jlunder/amanita-arcade/hardware/analysis.ods

Options -
 | Iterm | Ircvr | Ileds
a) Active termination (2.5V) | 0.05 | 0.023 | 0.02 | 0.093
b) Passive termination (2.5V) | 0.005 | 0.023 | 0.02 | 0.048
