jlunder/amanita-arcade/data-source/fonts/nixie_numbers.jpg

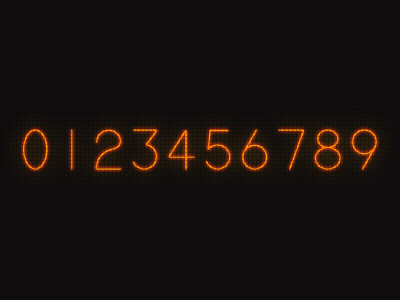
data-source/fonts/nixie_numbers.jpg
