jlunder/amanita-arcade/hardware/assembly-2019-06-28/aa-bom-v1.ods

AA-POWER
Designator | Package | Qty | Designation
C2, C1 | CP_Radial_D5.0mm_P2.50mm | 2 | 10u
C4, C3 | C_0805_2012Metric | 2 | 1u
CN1 | SolderWirePad_1x02_P5.08mm_Drill1.5mm | 1 | VIN_A
CN2 | SolderWirePad_1x02_P5.08mm_Drill1.5mm | 1 | VIN_B
CN3 | TerminalBlock_OST_OSTYK44108030 | 1 | 12V_OUT
CN4 | TerminalBlock_OST_OSTYK44108030 | 1 | GND_OUT
D2, D1 | D_SOD-923 | 2 | DF2S16FS
D3, D4, D7 | LED_0603_1608Metric | 3 | LED
D5, D6 | D_SOD-128 | 2 | TSS83L45
D8 | D_DO-35_SOD27_P2.54mm_Vertical_KathodeUp | 1 | BZX79C15
F1 | Fuseholder_Clip_5x20_Bel_FC-211-22 | 1 | 2A
Q1 | TO-220-3_Horizontal_TabDown | 1 | TN1610H
R2, R1, R3 | R_0603_1608Metric | 3 | 2.2k
R4 | R_0603_1608Metric | 1 | 470
R5 | R_0603_1608Metric | 1 | 10k
TP1, TP11, TP3, TP5, TP7, TP9 | TestPoint_Loop_D1.80mm_Drill1.0mm_Beaded | 6
TP12, TP10, TP8, TP6, TP4, TP2 | TestPoint_Loop_D1.80mm_Drill1.0mm_Beaded | 6 | GND
AA-DAUGHTERBOARD
Designator | Package | Qty | Designation
A1 | STM32F407_Discovery_P1_P2_Socket | 1
C1 | CP_Radial_D10.0mm_P2.50mm_P5.00mm | 1 | 100u
C13, C3, C6, C14, C7, C12 | C_0603_1608Metric | 6 | 0.1u
C17, C16, C9, C8, C2, C15 | C_0805_2012Metric | 6 | 1u
C4, C5 | C_0805_2012Metric | 2 | 10u
CN1 | BarrelJack_Horizontal | 1 | Barrel_Jack
CN12, CN11, CN13, CN5, CN10 | 6P6C_Assmann_A-2014-1-4 | 5 | 6P6C
CN15, CN16, CN14 | PinHeader_2x04_P2.54mm_Vertical | 3
CN19, CN18, CN17 | 8P8C_Assmann_A-2014-2S-4 | 3 | 8P8C
CN2 | SolderWirePad_1x02_P5.08mm_Drill1.5mm | 1
CN4, CN3 | PinHeader_1x06_P2.54mm_Vertical | 2
CN6, CN7, CN8, CN9 | PinHeader_1x04_P2.54mm_Vertical | 4
D14, D10, D11, D12, D13, D15, D16, D17, D18, D19 | SOT-23-6 | 10 | DT1042
D20, D21, D1, D9, D5, D4, D7, D8 | LED_0603_1608Metric | 8 | LED
D3 | D_SOD-923 | 1 | DF2S16FS
D6 | SOT-23-6 | 1 | D5V0P4UR6SO
F1 | Fuseholder_Clip_5x20_Bel_FC-211-22 | 1 | 0.5A
F5, F4, F3, F2 | Fuse_0805_2012Metric | 4 | 0.5A
R15 | R_0603_1608Metric | 1 | 33
R3, R4 | R_0603_1608Metric | 2 | 120
R33, R50, R30, R31, R28, R34, R43, R47, R21, R41, R39, R38, R37, R36, R55, R48, R32, R16, R46, R42, R54, R53, R52, R35, R51, R24, R23, R25, R44, R19, R26, R49, R45, R18, R22, R40, R20, R29, R17, R27 | R_0603_1608Metric | 40 | 56
R56, R10, R12 | R_0603_1608Metric | 3 | 10k
R57 | R_0603_1608Metric | 1 | 2.2k
R58 | R_0603_1608Metric | 1 | 680
R7, R6 | R_0603_1608Metric | 2 | 1k
R9, R8, R11, R13, R14, R2 | R_0603_1608Metric | 6 | 220
TP32, TP13, TP6, TP1, TP2, TP3, TP4, TP14, TP31, TP12, TP5, TP7, TP8, TP11, TP10, TP9, TP16, TP24, TP17, TP18, TP19, TP20, TP21, TP23, TP25, TP26, TP27, TP28, TP29, TP15, TP22, TP30 | TestPoint_THTPad_D2.0mm_Drill1.0mm | 32
U1 | DIP-8_W7.62mm_Socket | 1 | 24LC08
U2 | DFN-10-1EP_3x3mm_P0.5mm_EP1.75x2.7mm | 1 | NIS5132xx
U3 | TO-220-3_Horizontal_TabDown | 1 | uA7805
U3_ALT | PinHeader_1x03_P2.54mm_Vertical | 1
U7, U6, U5, U4, U8 | SOIC-16_3.9x9.9mm_P1.27mm | 5 | 75ALS192
AA-STALK-RECEIVER
Designator | Package | Qty | Designation
C101 | CP_Radial_D10.0mm_P2.50mm_P5.00mm | 1 | 100u
C102 | CP_Radial_D5.0mm_P2.50mm | 1 | 10u
C103, C204 | C_0805_2012Metric | 2 | 1u
C202, C203, C301 | C_0805_2012Metric | 3 | 0.1u
C311, C312 | C_0805_2012Metric | 2 | 10u
CN101 | SolderWirePad_1x02_P7.62mm_Drill2.5mm | 1
CN102 | 6P6C_Assmann_A-2014-1-4 | 1 | 6P6C
CN151 | PinHeader_1x04_P2.54mm_Vertical | 1
CN301, CN302, CN303 | PinHeader_1x03_P2.54mm_Vertical | 3
CN314, CN313, CN312, CN311 | PinHeader_1x02_P2.54mm_Vertical | 4
D101 | D_SOD-923 | 1 | DF2S16FS
D102 | SOT-23-6 | 1 | D5V0P4UR6SO
D151, D152, D352, D351 | D_0603_1608Metric | 4 | LED
D204, D202, D201, D203 | D_DO-35_SOD27_P7.62mm_Horizontal | 4 | BZX79C2V7
JP101 | PinHeader_1x02_P2.54mm_Vertical | 1
Q301 | SOT-23 | 1 | KST10
Q311, Q312 | SOT-323_SC-70 | 2 | MCH3484
R151 | R_0603_1608Metric | 1 | 1.5k
R201, R204, R202, R203 | R_0603_1608Metric | 4 | 56
R301, R302 | R_0603_1608Metric | 2 | 1k
R351, R352, R152 | R_0603_1608Metric | 3 | 470
TP101, TP102, TP201, TP202, TP301, TP302, TP303, TP311 | TestPoint_Loop_D1.80mm_Drill1.0mm_Beaded | 8
TP151, TP152, TP153, TP251, TP351, TP352, TP361, TP252 | TestPoint_Loop_D1.80mm_Drill1.0mm_Beaded | 8 | GND
U201 | SOIC-16_3.9x9.9mm_P1.27mm | 1 | ST26C32
AA-PANEL-RECEIVER
Designator | Package | Qty | Designation
C101 | CP_Radial_D10.0mm_P2.50mm_P5.00mm | 1 | 100u
C102 | CP_Radial_D6.3mm_P2.50mm | 1 | 10u
C201, C301 | C_0603_1608Metric | 2 | 1u
C321, C311, C202, C304, C203, C204, C211, C221, C302, C303 | C_0603_1608Metric | 10 | 0.1u
CN102, CN101 | SolderWirePad_1x02_P5.08mm_Drill1.5mm | 2 | Conn_01x02
CN301, CN201 | 8P8C_Assmann_A-2014-2S-4 | 2 | 8P8C
CN351, CN302, CN251, CN202 | PinHeader_2x04_P2.54mm_Vertical | 4 | Conn_01x08
D102, D101 | D_SOD-128 | 2 | TSS83L45
D151, D152 | LED_0603_1608Metric | 2 | LED
D222, D322, D321, D312, D311, D221, D212, D211 | D_DO-35_SOD27_P2.54mm_Vertical_KathodeUp | 8 | D_Zener
D301, D302, D202, D201 | SOT-23-6 | 4 | D5V0P4UR6SO
R151, R152 | R_0603_1608Metric | 2 | 470
R304, R307, R303, R308, R301, R302, R306, R305, R208, R205, R206, R207, R201, R202, R203, R204 | R_0603_1608Metric | 16 | 56
TP101, TP102, TP103, TP104, TP201, TP202, TP203, TP204, TP211, TP221, TP201, TP302, TP303, TP304, TP311, TP321 | TestPoint_Loop_D1.80mm_Drill1.0mm_Beaded | 16
TP151, TP153, TP254, TP251, TP252, TP253, TP152, TP271, TP371, TP361, TP354, TP353, TP351, TP352, TP261 | TestPoint_Loop_D1.80mm_Drill1.0mm_Beaded | 15 | GND
U101 | Converter_DCDC_muRata_CRE1xxxxxx3C_THT | 1 | CRE1S0505S3C
U301, U201 | SOIC-16_3.9x9.9mm_P1.27mm | 2 | ST26C32
U302, U202 | QSOP-16_3.9x4.9mm_P0.635mm | 2 | Si8640EB-B-IU
AA-INPUT-CONTROLLER
Designator | Package | Qty | Designation
A201 | STM32F103_Bluepill | 1
C101 | CP_Radial_D10.0mm_P2.50mm_P5.00mm | 1 | 10u
C211,C221,C231,C241 | C_0805_2012Metric | 4 | 1u
CN101 | SolderWirePad_1x02_P5.08mm_Drill1.5mm | 1
CN201 | 6P6C_Assmann_A-2014-1-4 | 1 | INPUT
CN202 | Connector_SonyPS2DualShock_Female | 1
CN203,CN251 | PinHeader_1x06_P2.54mm_Vertical | 2
CN211 | 6P6C_Assmann_A-2014-1-4 | 1 | BTN_R
CN221 | 6P6C_Assmann_A-2014-1-4 | 1 | BTN_G
CN231 | 6P6C_Assmann_A-2014-1-4 | 1 | BTN_B
CN241 | 6P6C_Assmann_A-2014-1-4 | 1 | BTN_P
Q231,Q221,Q211,Q241 | SOT-323_SC-70 | 4 | MCH3484
R208,R201 | R_0603_1608Metric | 2 | 1k
R209,R202 | R_0603_1608Metric | 2 | 120
R241, R231, R221, R207, R206, R205, R204, R203, R211 | R_0603_1608Metric | 9 | 4.7k
TP101, TP102, TP211, TP212, TP213, TP221, TP222, TP223, TP231, TP232, TP233, TP241, TP242, TP243 | TestPoint_Loop_D1.80mm_Drill1.0mm_Beaded | 14
TP151, TP152, TP251, TP252, TP253, TP254, TP261, TP271, TP281, TP291 | TestPoint_Loop_D1.80mm_Drill1.0mm_Beaded | 10 | GND
U101 | TO-220-3_Horizontal_TabDown | 1 | LM7805_TO220
