jlunder/amanita-arcade/hardware/assembly-2019-06-28/aa-daughterboard.pdf

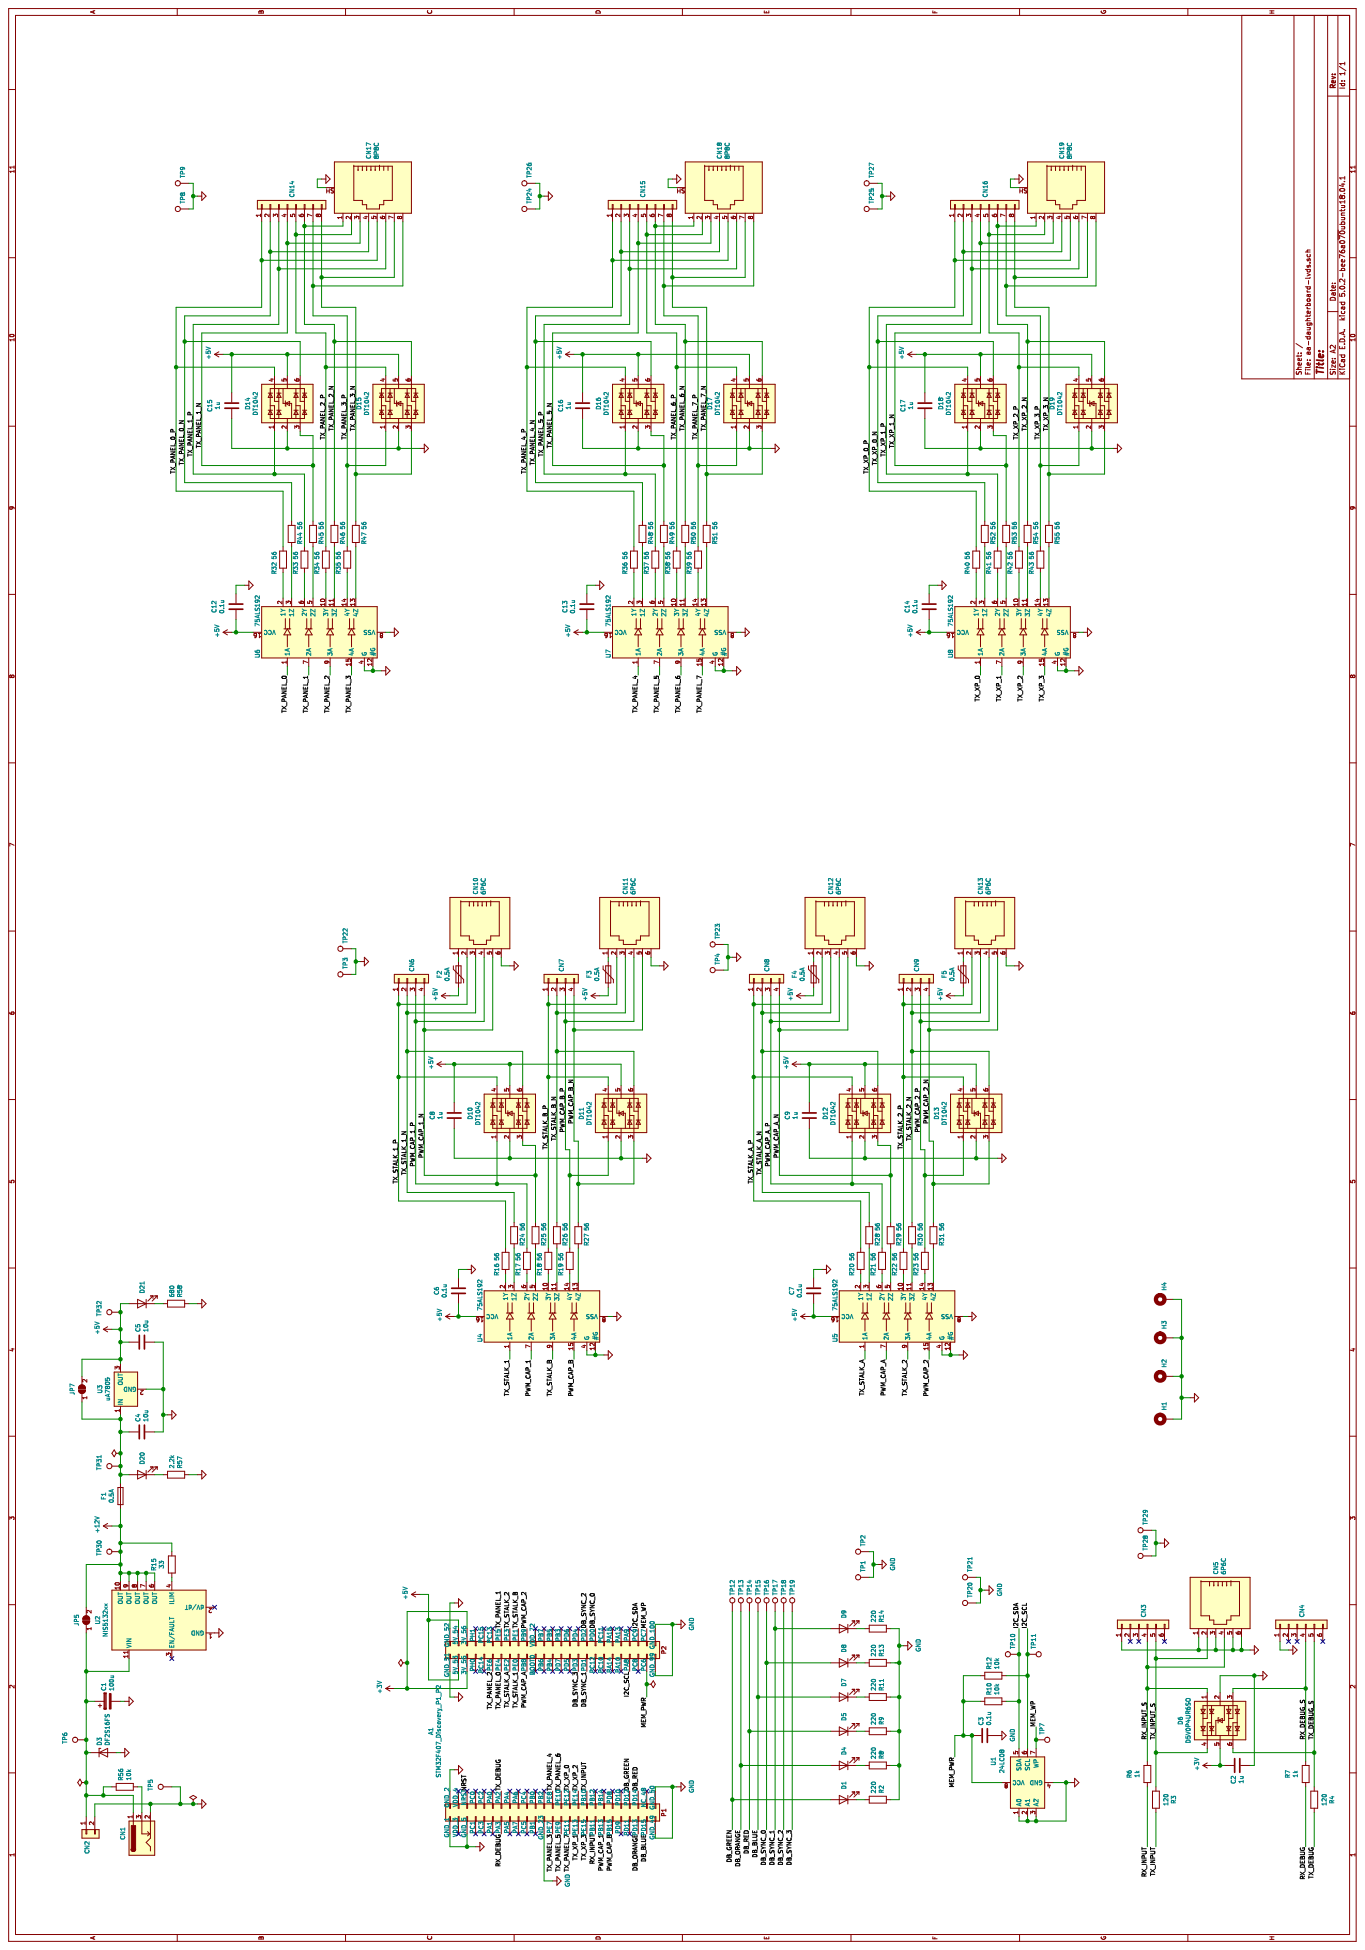
[picture p2: page 1]
