jlunder/amanita-arcade/hardware/assembly-2019-06-28/aa-input-controller.pdf

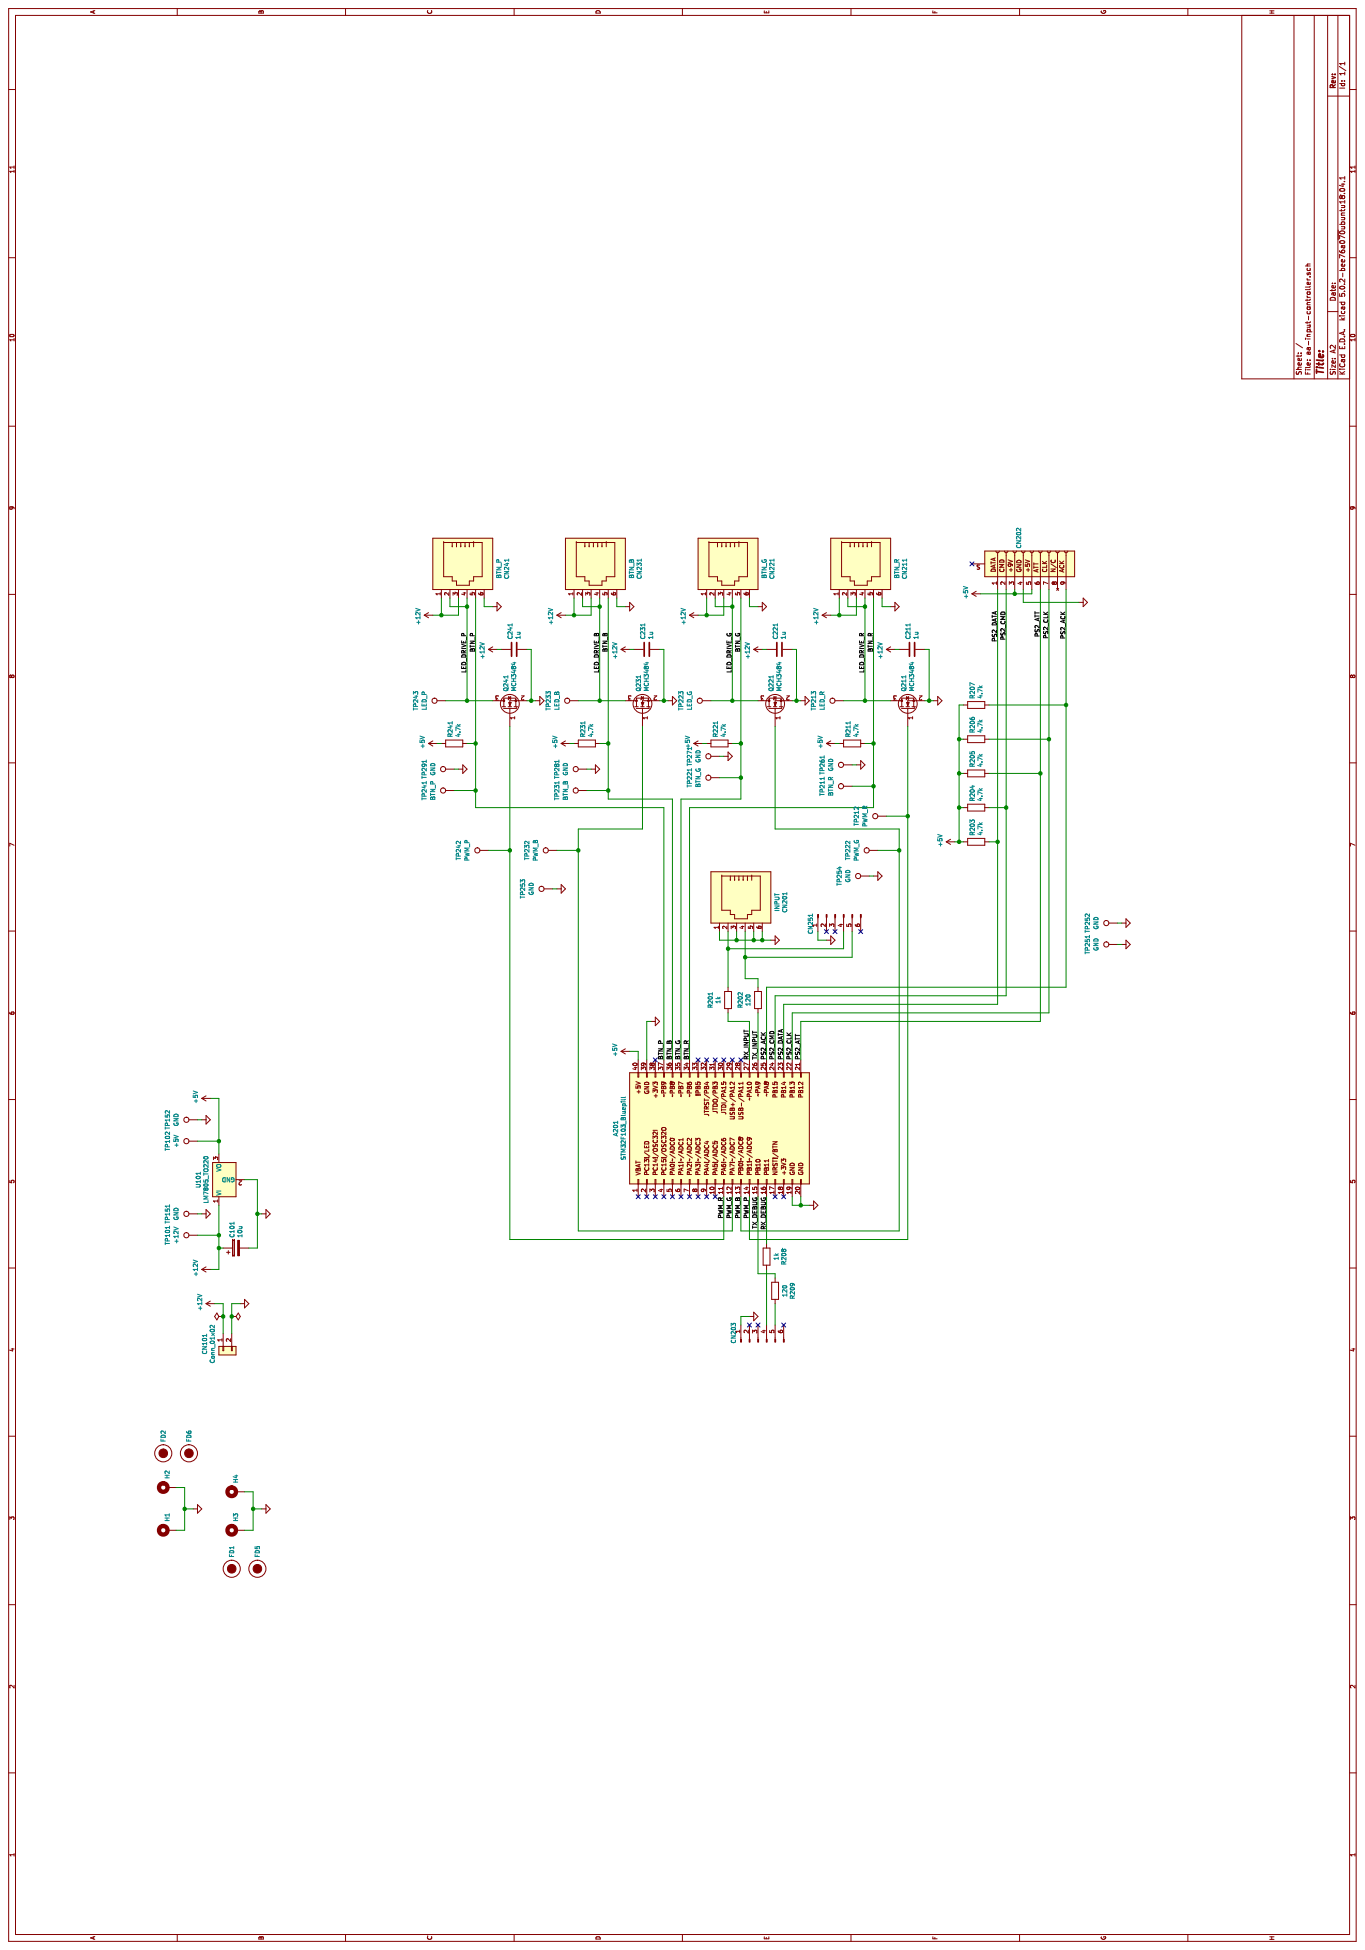
[picture p3: page 1]
