jlunder/amanita-arcade/hardware/assembly-2019-06-28/aa-panel-receiver.pdf

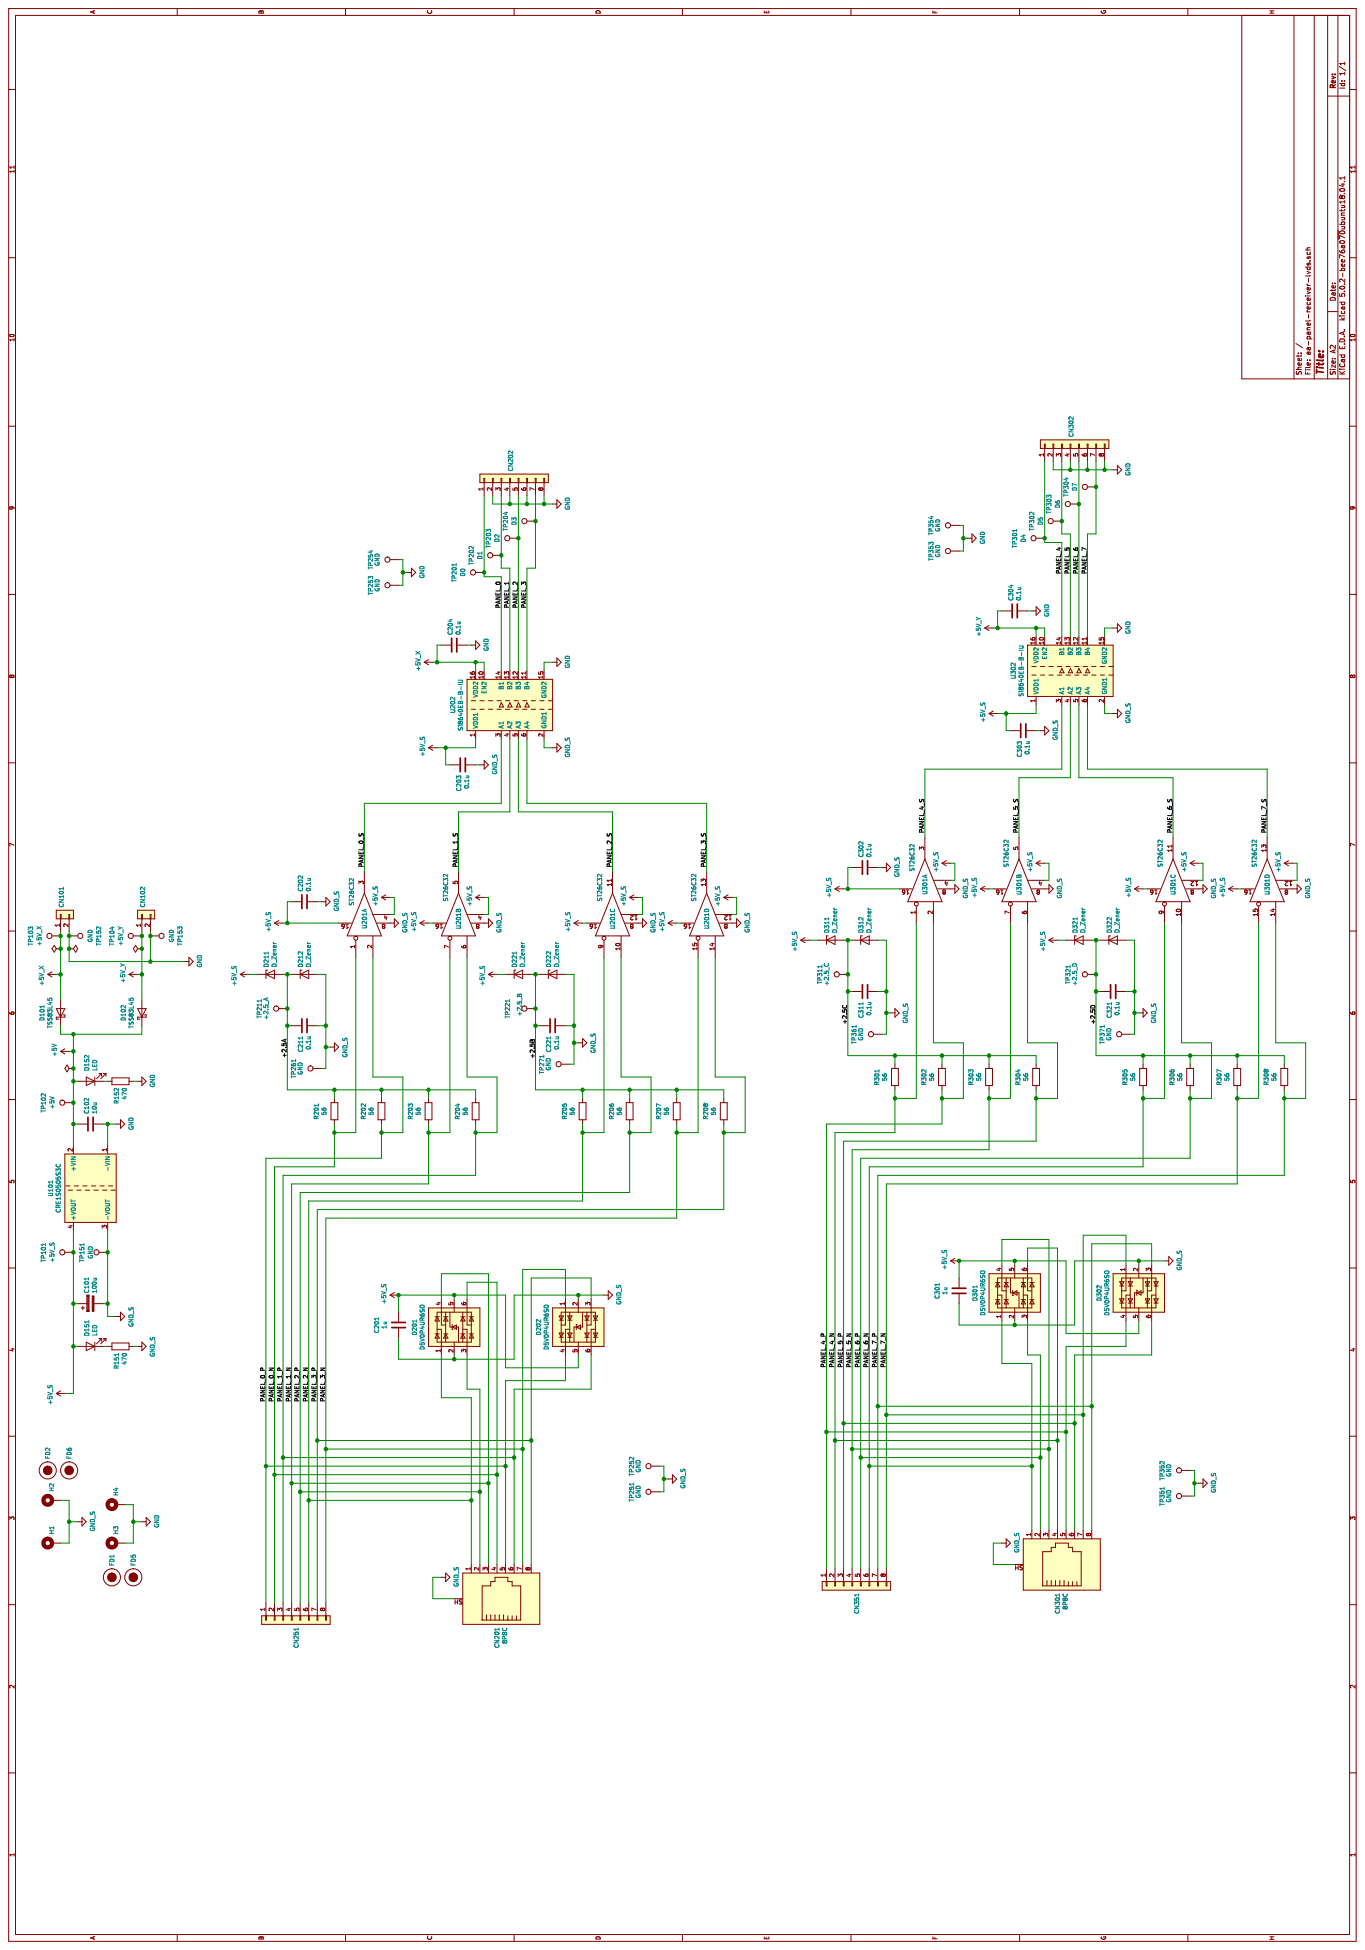
[picture p4: page 1]
