jlunder/amanita-arcade/hardware/assembly-2019-06-28/aa-power.pdf

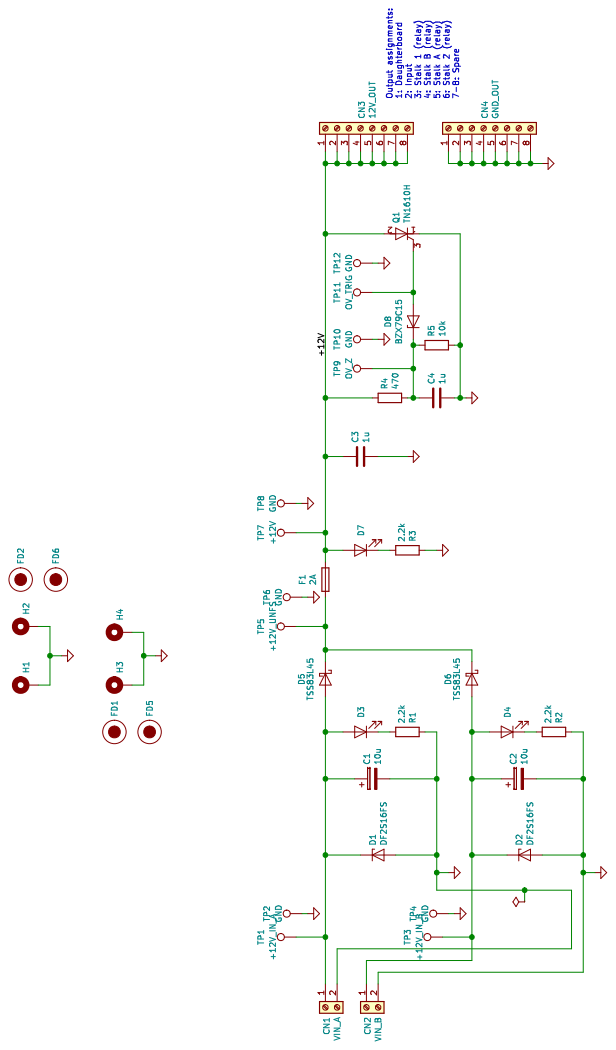
[picture p5: page 1]
