jlunder/amanita-arcade/hardware/assembly-2019-06-28/aa-stalk-receiver.pdf

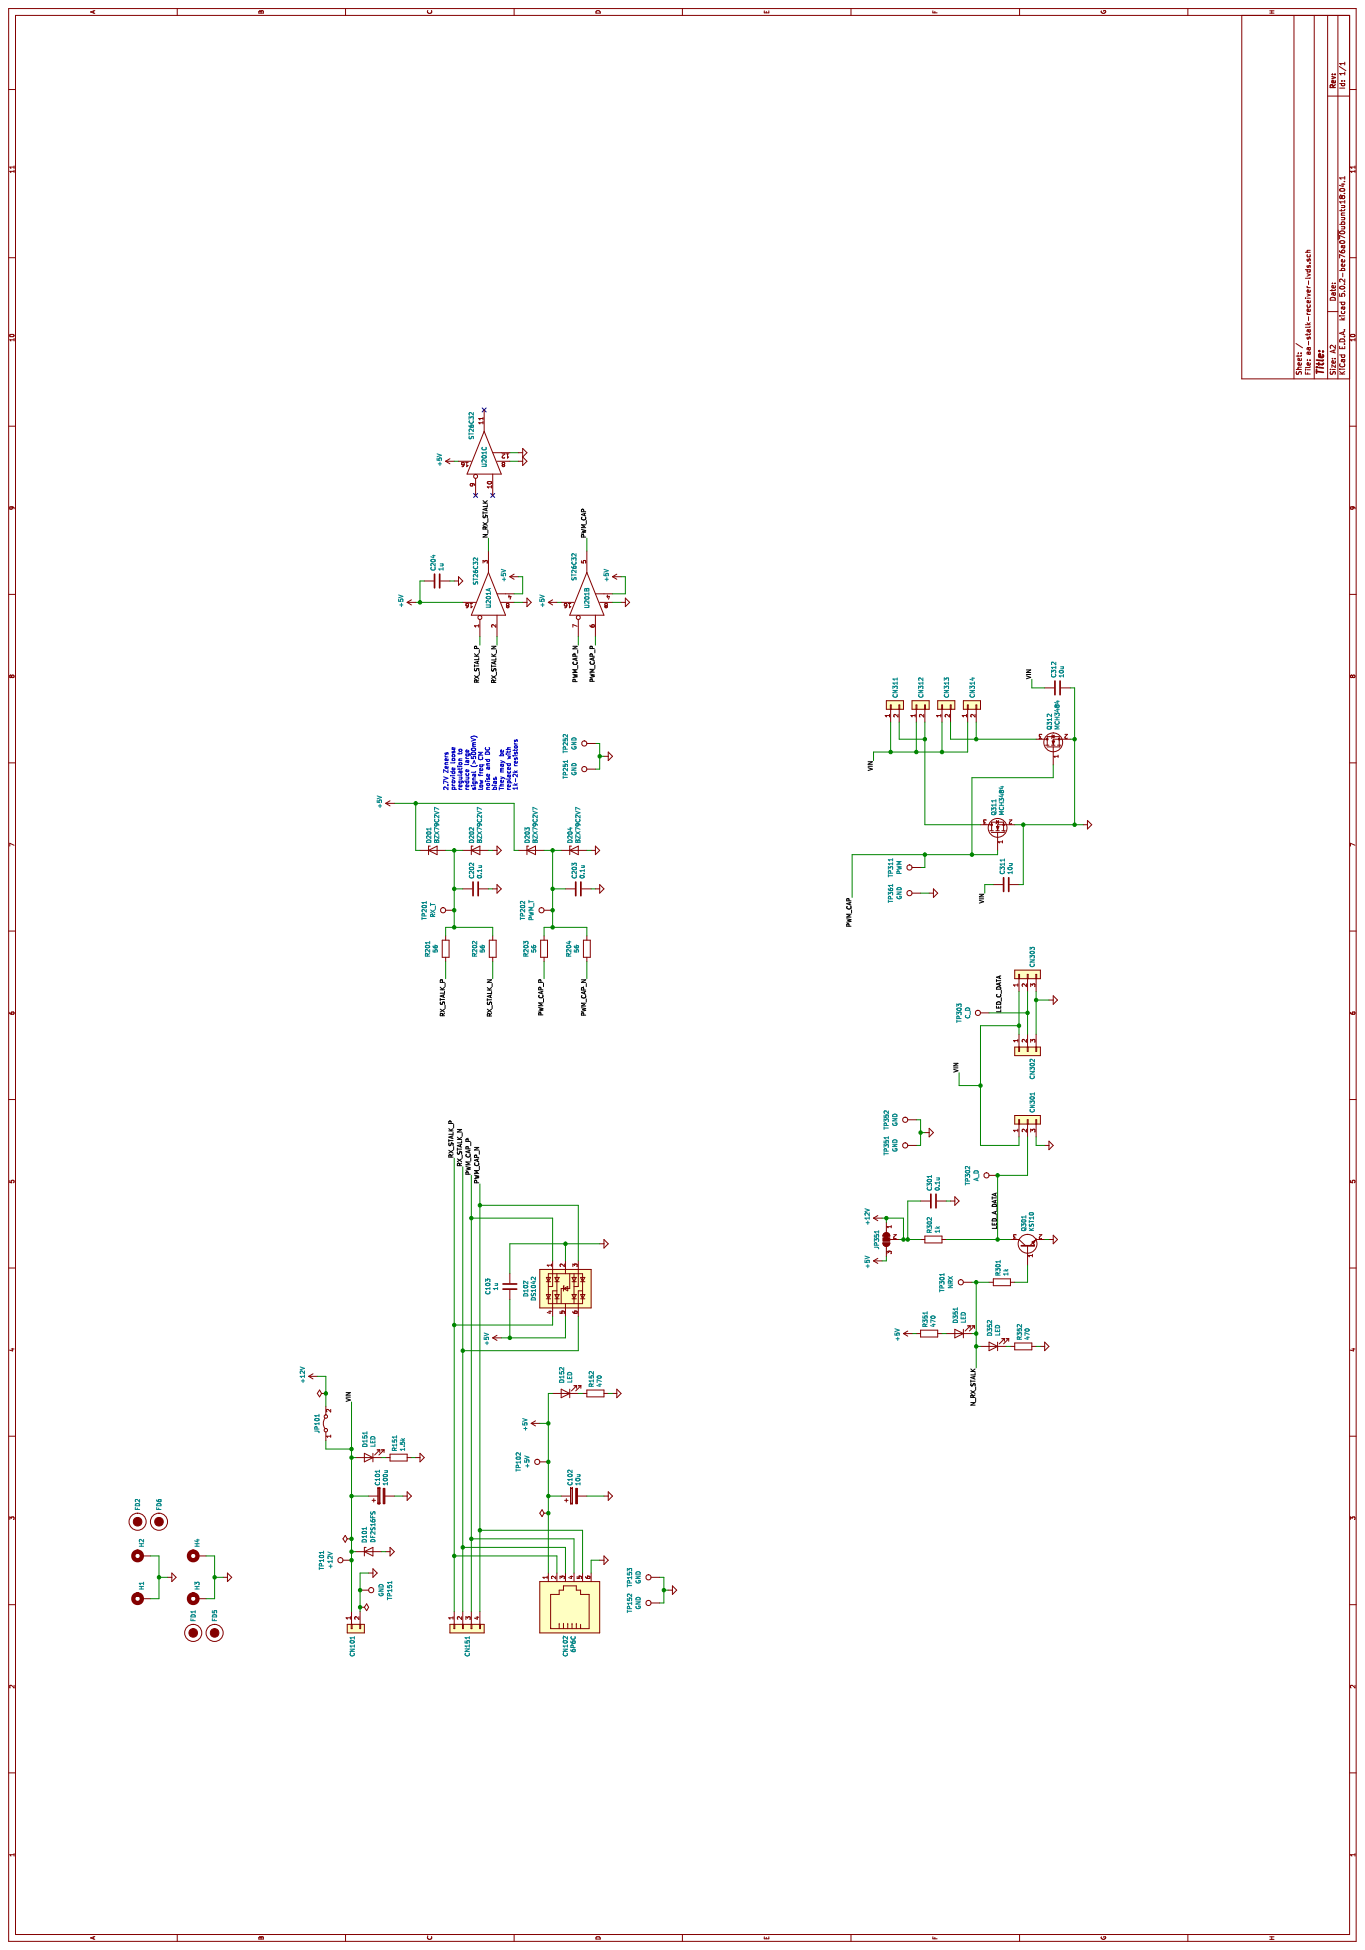
[picture p6: page 1]
