jlunder/amanita-arcade/hardware/aa-stalk-receiver-lvds/aa-stalk-receiver-lvds.kicad_pcb

## KiCad design hardware/aa-stalk-receiver-lvds/aa-stalk-receiver-lvds.kicad_pcb (2019-08-08)

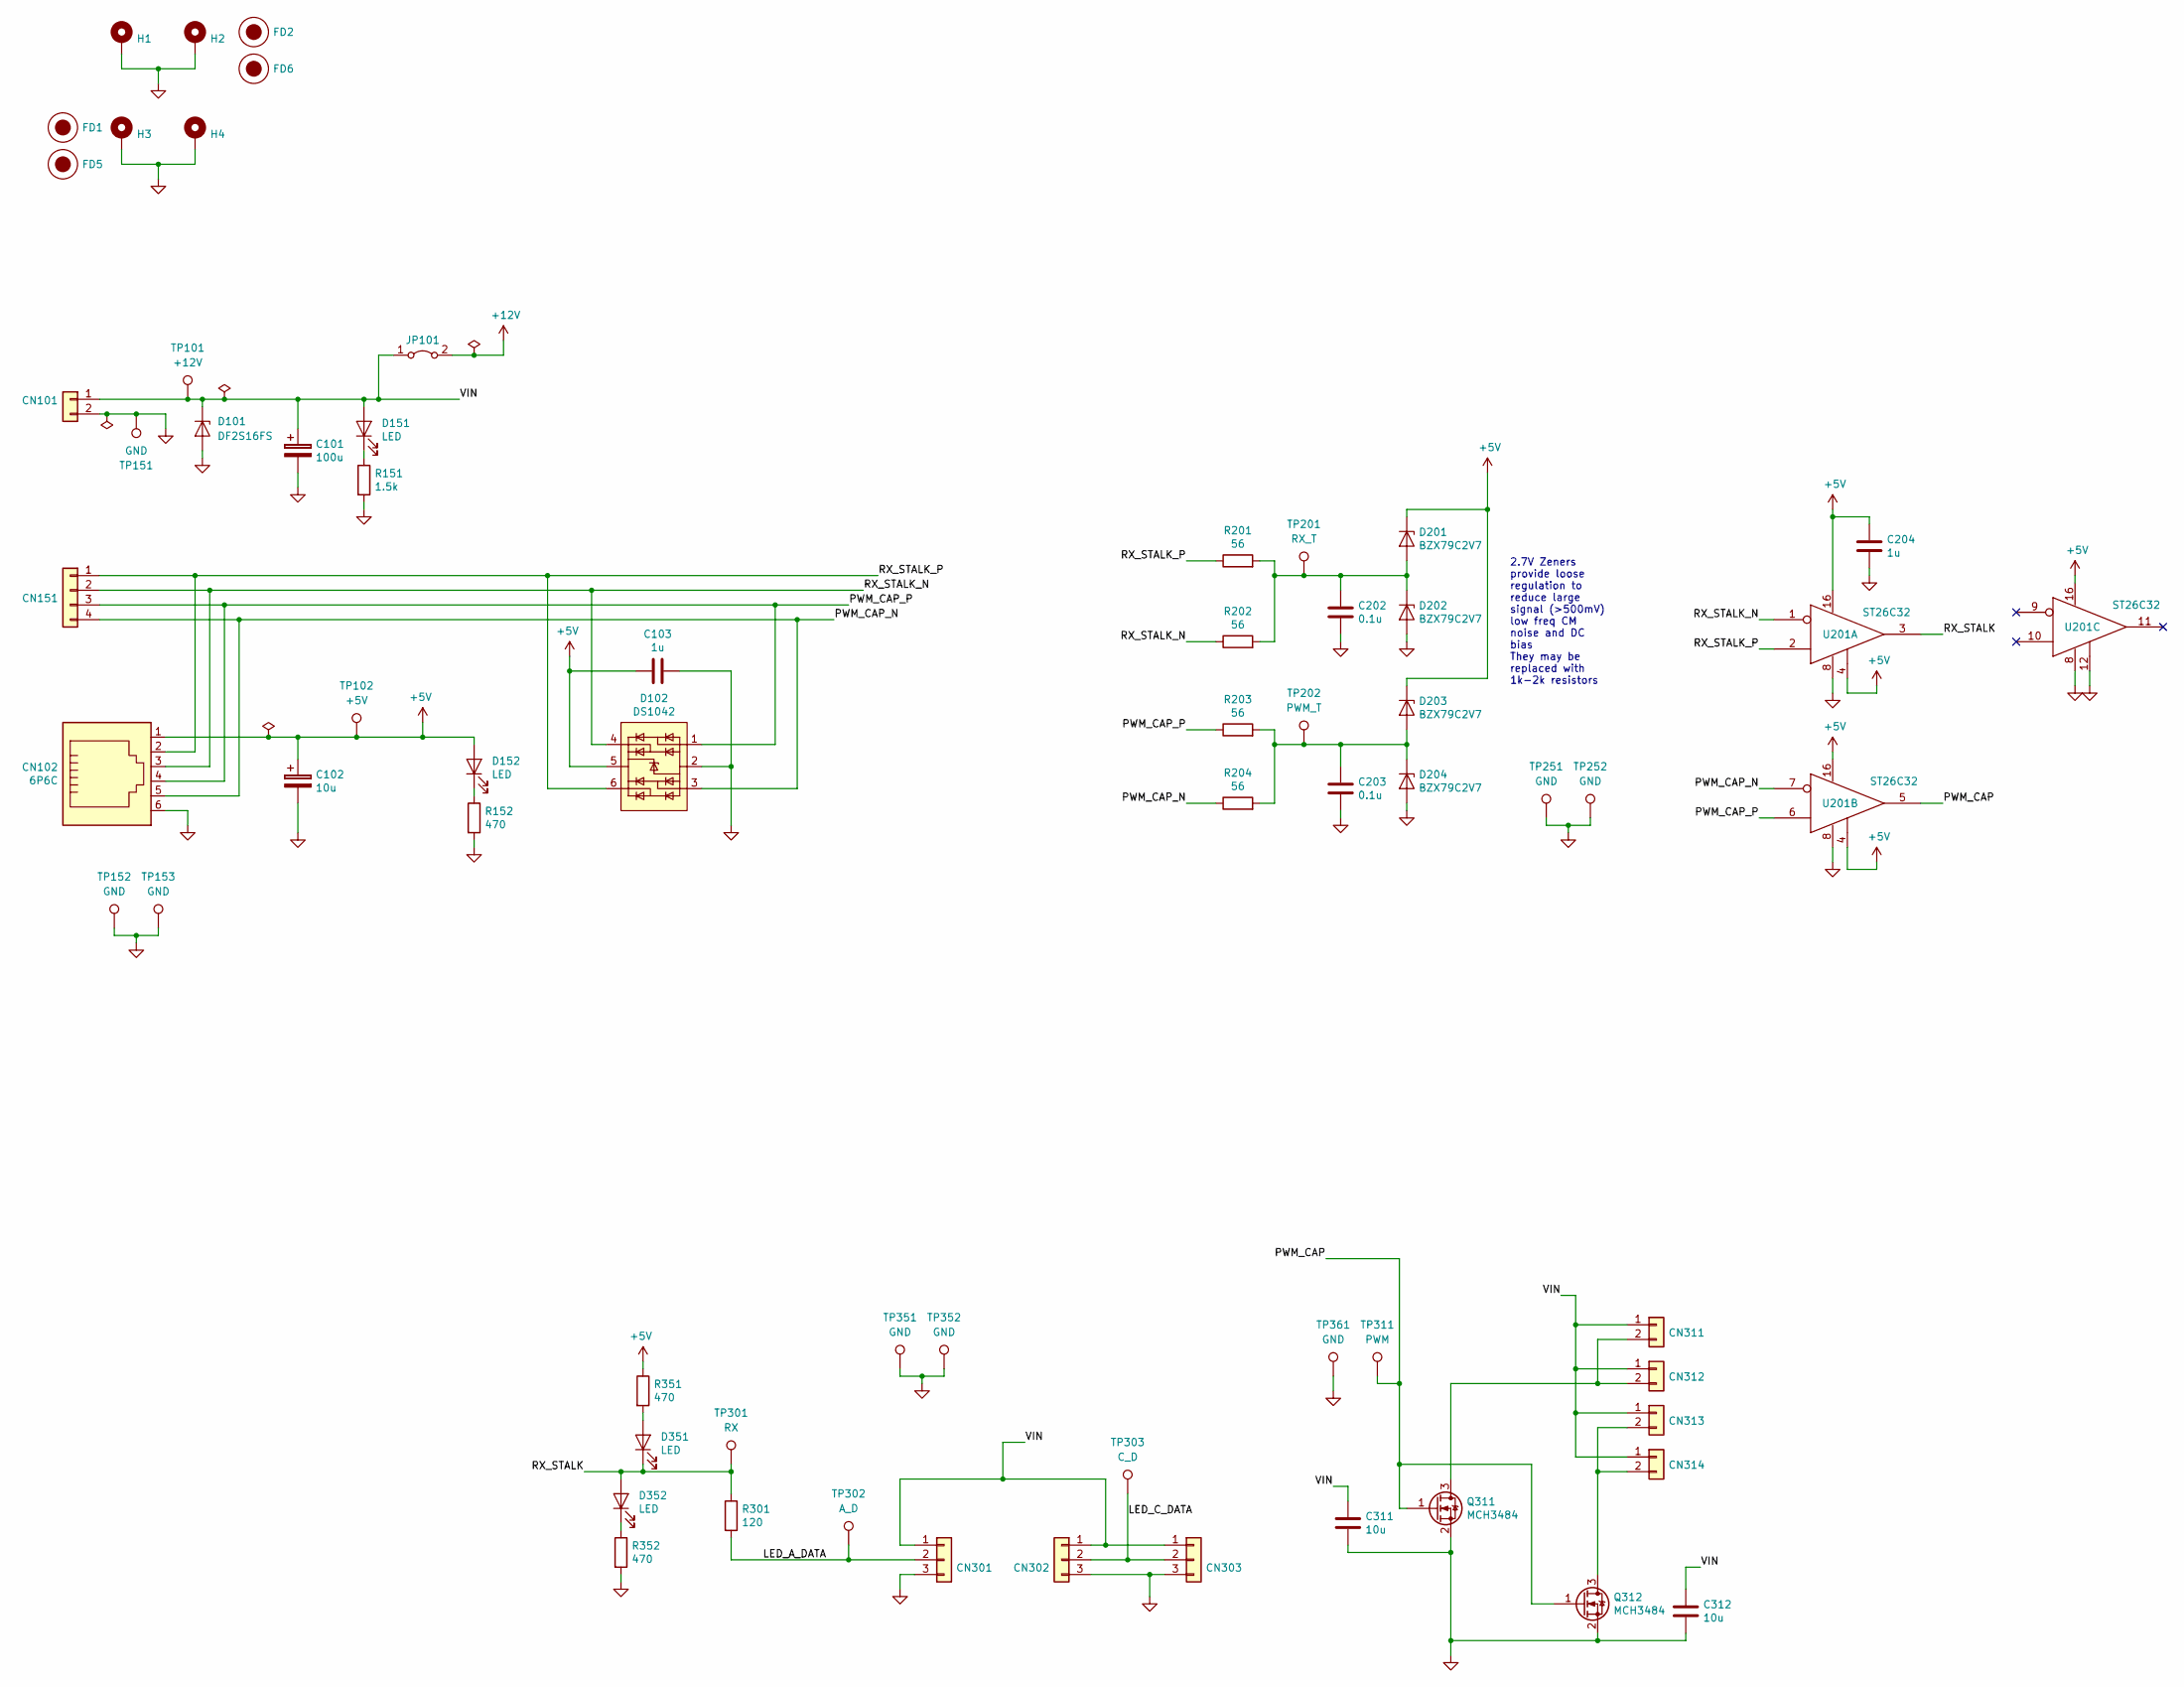
[picture p7: schematic aa-stalk-receiver-lvds.sch]

Parts:
C101: 100u; CP_Radial_D10.0mm_P2.50mm_P5.00mm
C102: 10u; CP_Radial_D5.0mm_P2.50mm
C103, C204: 1u; C_0805_2012Metric
C202, C203: 0.1u; C_0805_2012Metric
C311, C312: 10u; C_0805_2012Metric
CN101: Conn_01x02; SolderWirePad_1x02_P7.62mm_Drill2.5mm
CN102: 6P6C; 6P6C_Assmann_A-2014-1-4
CN151: Conn_01x04; PinHeader_1x04_P2.54mm_Vertical
CN301, CN302, CN303: Conn_01x03; PinHeader_1x03_P2.54mm_Vertical
CN311, CN312, CN313, CN314: Conn_01x02; PinHeader_1x02_P2.54mm_Vertical
D101: DF2S16FS; D_SOD-923
D102: DS1042; SOT-23-6
D151, D152, D351, D352: LED; D_0603_1608Metric
D201, D202, D203, D204: BZX79C2V7; D_DO-35_SOD27_P7.62mm_Horizontal
FD1, FD2: Fiducial; Fiducial_1mm_Dia_2.54mm_Outer_CopperTop
FD5, FD6: Fiducial; StencilAlignment_1.27mm
H1, H2, H3, H4: MountingHole_Pad; MountingHole_2.7mm_M2.5_Pad_Via
JP101: Jumper_2_Bridged; PinHeader_1x02_P2.54mm_Vertical
Q311, Q312: MCH3484; SOT-323_SC-70
R151: 1.5k; R_0603_1608Metric
R152, R351, R352: 470; R_0603_1608Metric
R201, R202, R203, R204: 56; R_0603_1608Metric
R301: 120; R_0603_1608Metric
TP101: +12V; TestPoint_Loop_D1.80mm_Drill1.0mm_Beaded
TP102: +5V; TestPoint_Loop_D1.80mm_Drill1.0mm_Beaded
TP151, TP152, TP153, TP251, TP252, TP351, TP352, TP361: GND; TestPoint_Loop_D1.80mm_Drill1.0mm_Beaded
TP201: RX_T; TestPoint_Loop_D1.80mm_Drill1.0mm_Beaded
TP202: PWM_T; TestPoint_Loop_D1.80mm_Drill1.0mm_Beaded
TP301: RX; TestPoint_Loop_D1.80mm_Drill1.0mm_Beaded
TP302: A_D; TestPoint_Loop_D1.80mm_Drill1.0mm_Beaded
TP303: C_D; TestPoint_Loop_D1.80mm_Drill1.0mm_Beaded
TP311: PWM; TestPoint_Loop_D1.80mm_Drill1.0mm_Beaded
U201: ST26C32; SOIC-16_3.9x9.9mm_P1.27mm

Connections:
+5V: C102.1, C103.2, C204.1, CN102.1, D102.5 (K), D152.2 (A), D201.1 (K), D203.1 (K), R351.1, TP102.1, U201.4 (ENABLE), U201.16 (VCC)
+12V: JP101.2 (B)
/LED_A_DATA: CN301.2, R301.2, TP302.1
/LED_C_DATA: CN302.2, CN303.2, TP303.1
/PWM_CAP: Q311.1 (G), Q312.1 (G), TP311.1, U201.5 (OUT)
/PWM_CAP_N: CN102.5, CN151.4, D102.3 (K), R204.1, U201.7 (E-)
/PWM_CAP_P: CN102.4, CN151.3, D102.1 (K), R203.1, U201.6 (E+)
/RX_STALK: D351.1 (K), D352.2 (A), R301.1, TP301.1, U201.3 (OUT)
/RX_STALK_N: CN102.3, CN151.2, D102.4 (K), R202.1, U201.1 (E-)
/RX_STALK_P: CN102.2, CN151.1, D102.6 (K), R201.1, U201.2 (E+)
/VIN: C101.1, C311.1, C312.1, CN101.1, CN301.1, CN302.1, CN303.1, CN311.1, CN312.1, CN313.1, CN314.1, D101.1 (K), D151.2 (A), JP101.1 (A), TP101.1
GND: C101.2, C102.2, C103.1, C202.2, C203.2, C204.2, C311.2, C312.2, CN101.2, CN102.6, CN301.3, CN302.3, CN303.3, D101.2 (A), D102.2 (A), D202.2 (A), D204.2 (A), H1.1, H2.1, H3.1, H4.1, Q311.2 (S), Q312.2 (S), R151.2, R152.2, R352.2, TP151.1, TP152.1, TP153.1, TP251.1, TP252.1, TP351.1, TP352.1, TP361.1, U201.8 (GND), U201.12 (ENABLE)
unnamed: C202.1, D201.2 (A), D202.1 (K), R201.2, R202.2, TP201.1
unnamed: C203.1, D203.2 (A), D204.1 (K), R203.2, R204.2, TP202.1
unnamed: CN311.2, CN312.2, Q311.3 (D)
unnamed: CN313.2, CN314.2, Q312.3 (D)
unnamed: D151.1 (K), R151.1
unnamed: D152.1 (K), R152.1
unnamed: D351.2 (A), R351.2
unnamed: D352.1 (K), R352.1

Notes on the sheet:
2.7V Zeners provide loose regulation to reduce large signal (>500mV) low freq CM noise and DC bias They may be replaced with 1k-2k resistors

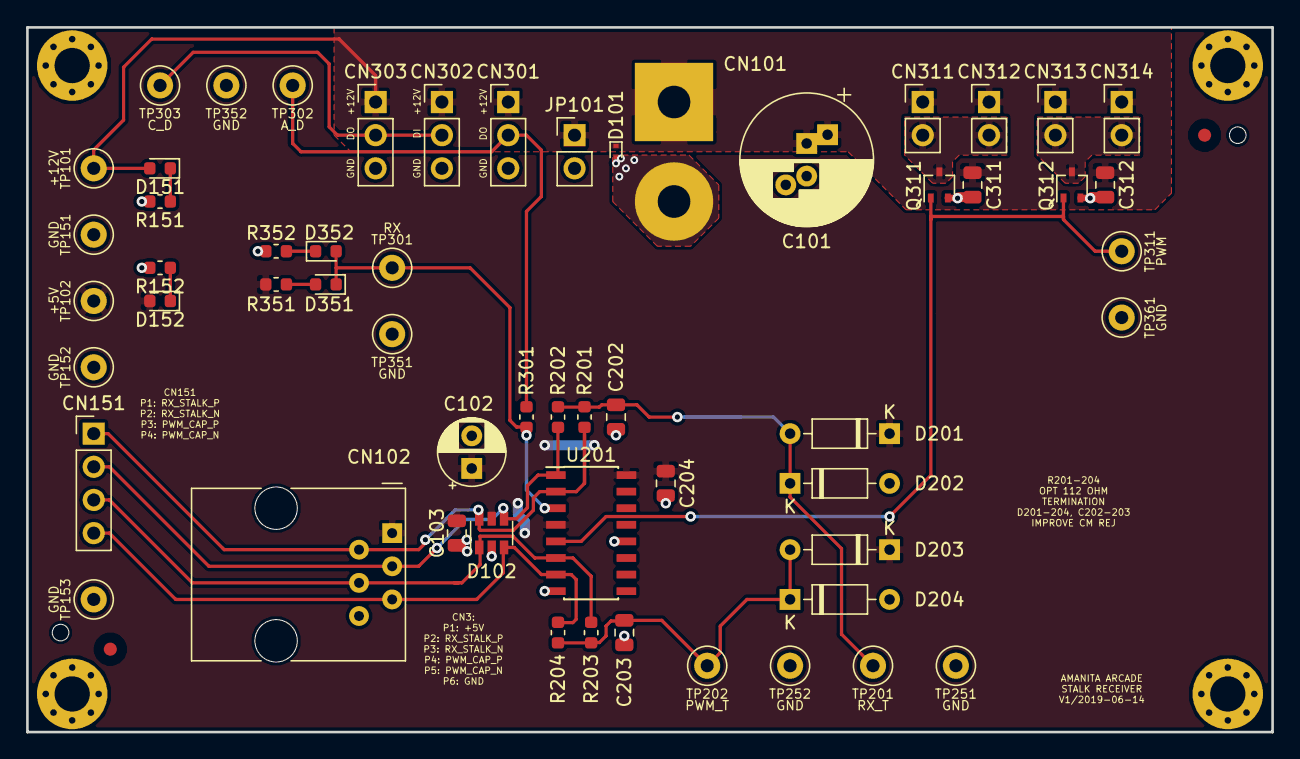
[picture p8: board aa-stalk-receiver-lvds.kicad_pcb from above]

Board: 2 copper layers, 95.4 x 54.0 mm, 65 parts (0 on the bottom side), 19 nets.
