jlunder/amanita-arcade/hardware/aa-daughterboard-lvds/aa-daughterboard-lvds.kicad_pcb

## KiCad design hardware/aa-daughterboard-lvds/aa-daughterboard-lvds.kicad_pcb (2019-08-08)

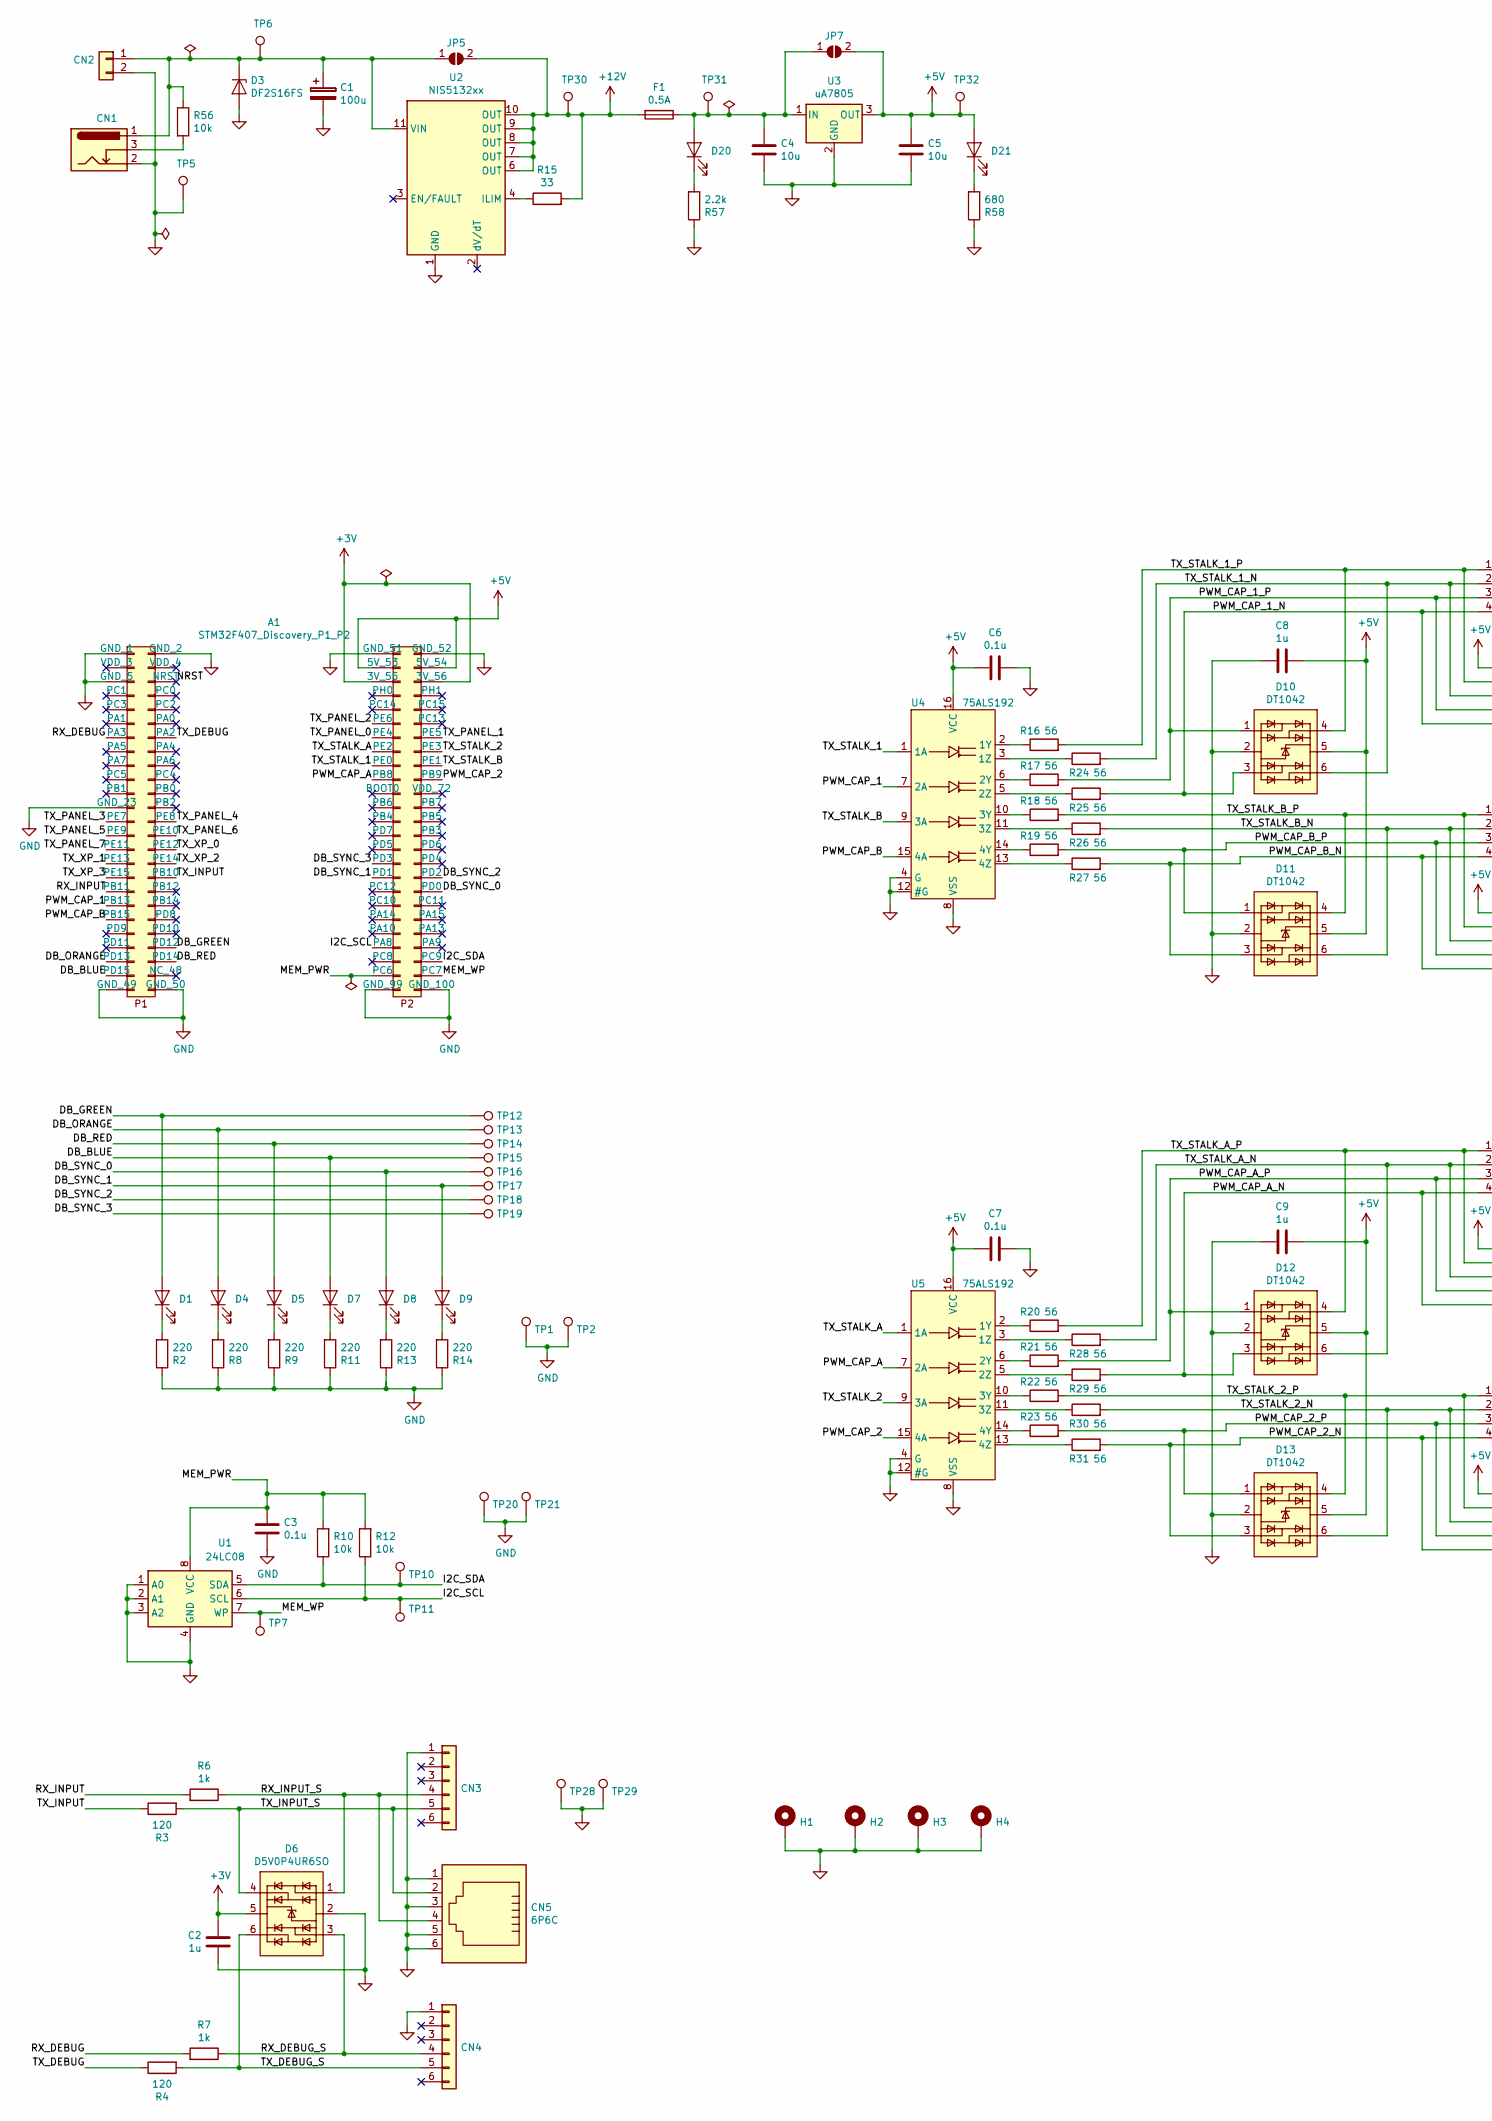
[picture p9: schematic aa-daughterboard-lvds.sch, part in row 1, column 1]

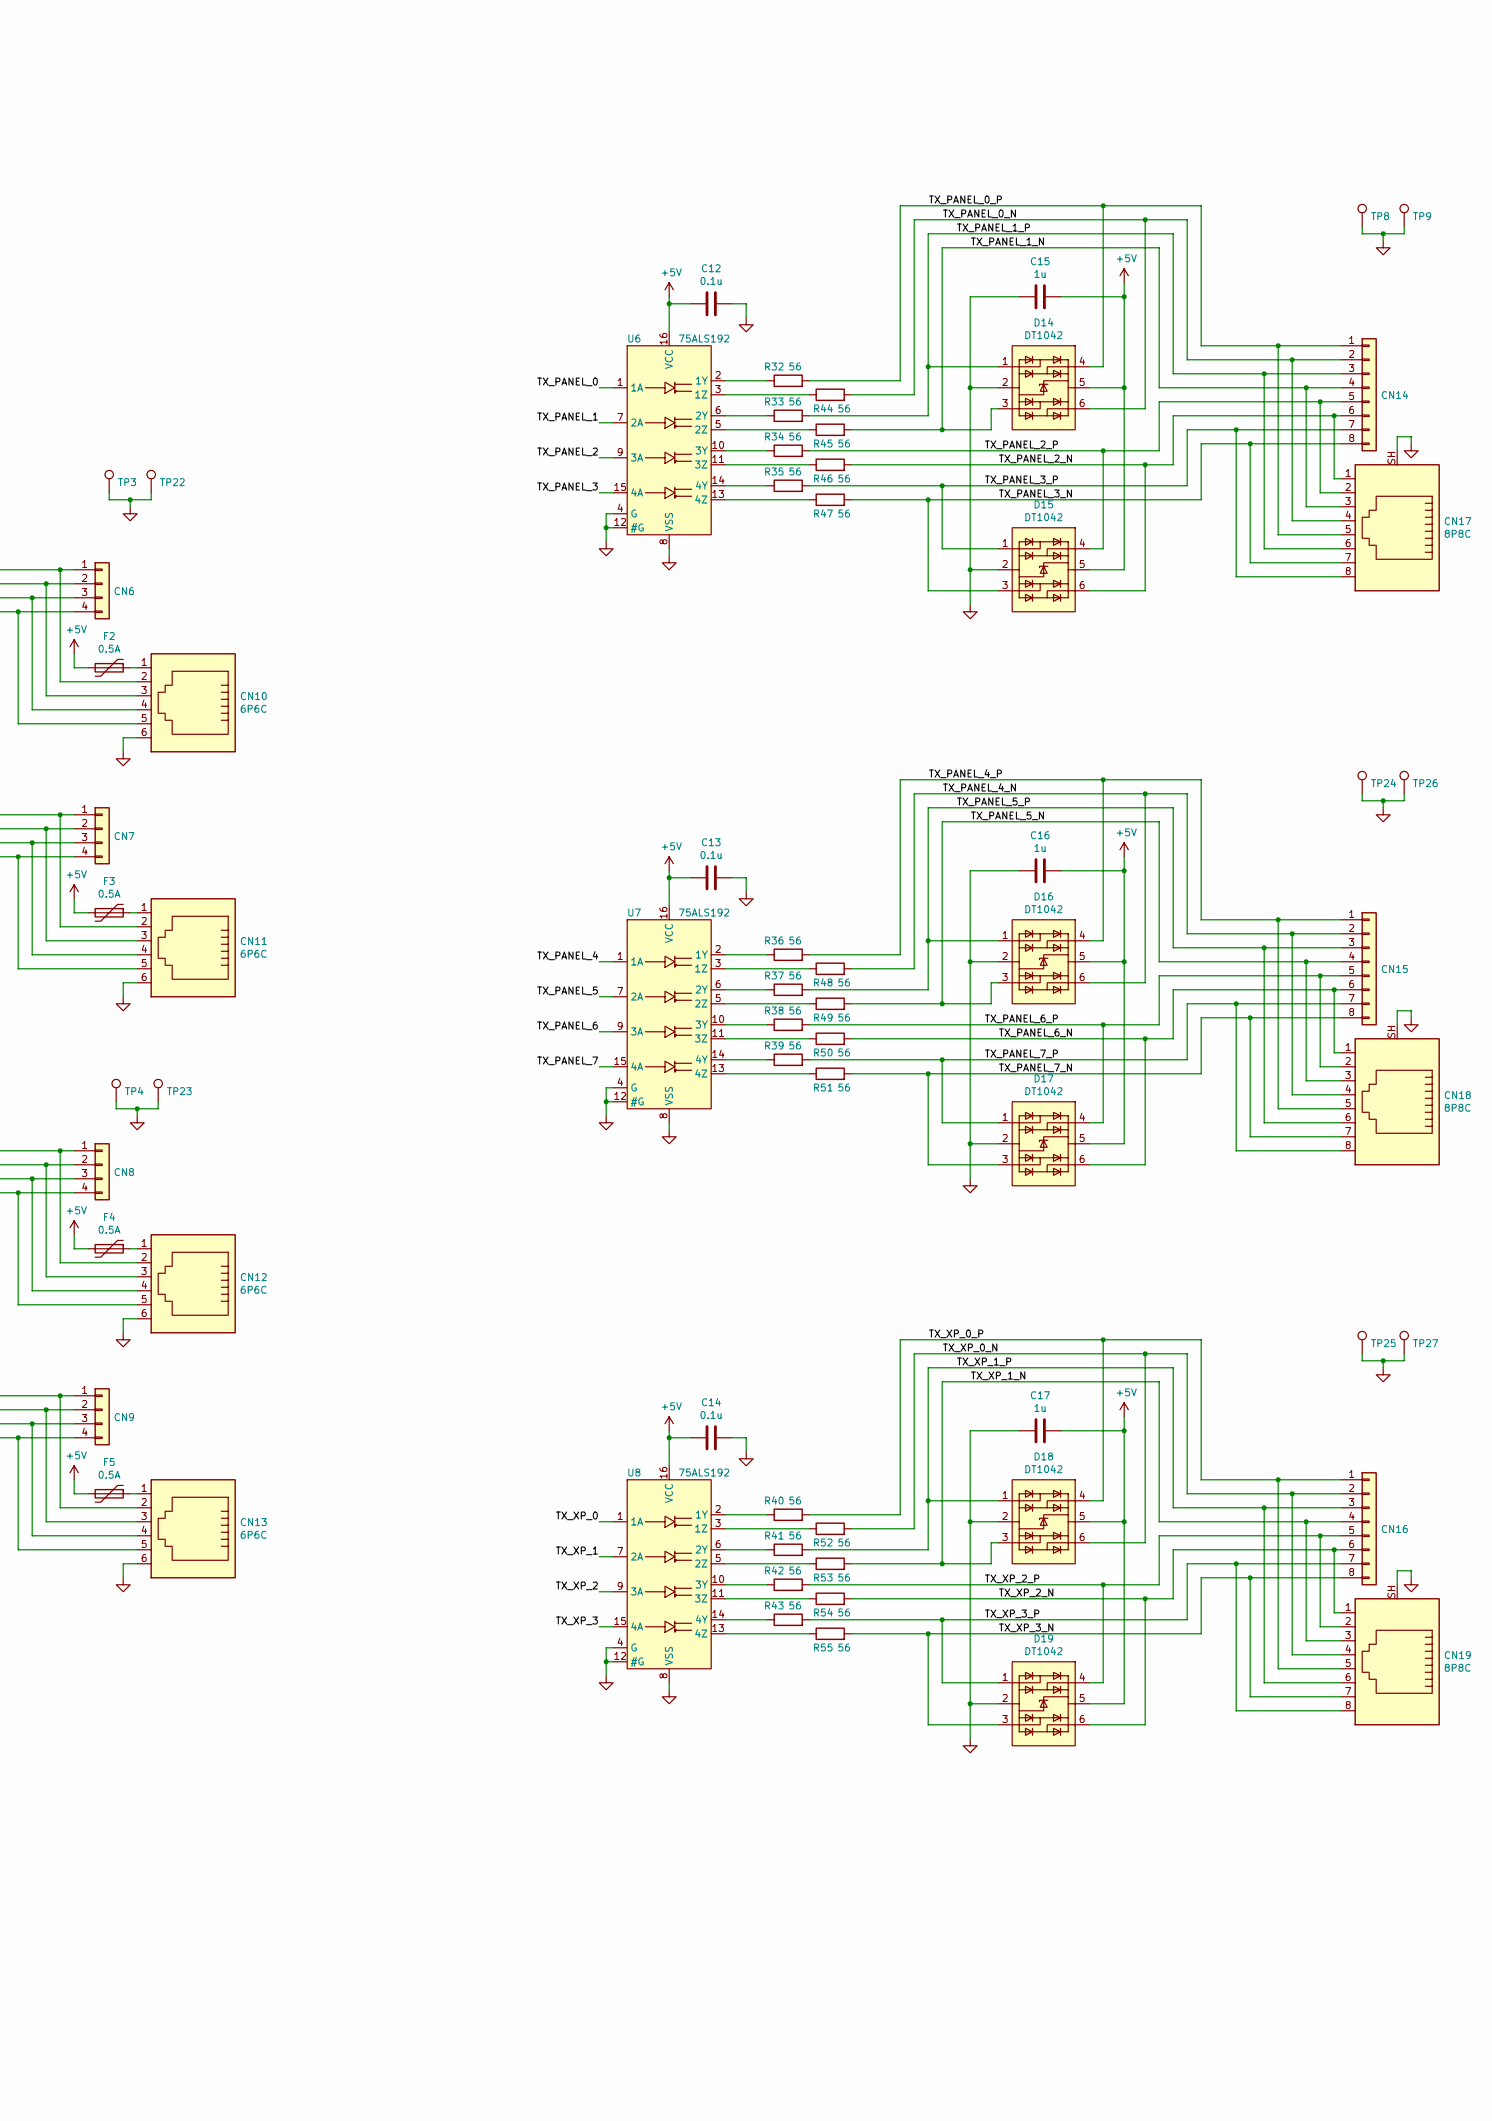
[picture p10: schematic aa-daughterboard-lvds.sch, part in row 1, column 2]

Parts:
A1: STM32F407_Discovery_P1_P2; STM32F407_Discovery_P1_P2_Socket
C1: 100u; CP_Radial_D10.0mm_P2.50mm_P5.00mm
C2, C8, C9, C15, C16, C17: 1u; C_0805_2012Metric
C3, C6, C7, C12, C13, C14: 0.1u; C_0603_1608Metric
C4, C5: 10u; C_0805_2012Metric
CN1: Barrel_Jack; BarrelJack_Horizontal
CN2: Conn_01x02; SolderWirePad_1x02_P5.08mm_Drill1.5mm
CN3, CN4: Conn_01x06; PinHeader_1x06_P2.54mm_Vertical
CN5, CN10, CN11, CN12, CN13: 6P6C; 6P6C_Assmann_A-2014-1-4
CN6, CN7, CN8, CN9: Conn_01x04; PinHeader_1x04_P2.54mm_Vertical
CN14, CN15, CN16: Conn_01x08; PinHeader_2x04_P2.54mm_Vertical
CN17, CN18, CN19: 8P8C; 8P8C_Assmann_A-2014-2S-4
D1, D4, D5, D7, D8, D9, D20, D21: LED; LED_0603_1608Metric
D3: DF2S16FS; D_SOD-923
D6: D5V0P4UR6SO; SOT-23-6
D10, D11, D12, D13, D14, D15, D16, D17, D18, D19: DT1042; SOT-23-6
F1: 0.5A; Fuseholder_Clip_5x20_Bel_FC-211-22
F2, F3, F4, F5: 0.5A; Fuse_0805_2012Metric
H1, H2, H3, H4: MountingHole_Pad; MountingHole_4.3mm_M4_Pad_Via
JP5, JP7: SolderJumper_2_Open; SolderJumper-2_P1.3mm_Open_RoundedPad1.0x1.5mm
R2, R8, R9, R11, R13, R14: 220; R_0603_1608Metric
R3, R4: 120; R_0603_1608Metric
R6, R7: 1k; R_0603_1608Metric
R10, R12, R56: 10k; R_0603_1608Metric
R15: 33; R_0603_1608Metric
R16, R17, R18, R19, R20, R21, R22, R23, R24, R25, R26, R27, R28, R29, R30, R31, R32, R33, R34, R35, R36, R37, R38, R39, R40, R41, R42, R43, R44, R45, R46, R47, R48, R49, R50, R51, R52, R53, R54, R55: 56; R_0603_1608Metric
R57: 2.2k; R_0603_1608Metric
R58: 680; R_0603_1608Metric
TP1, TP2, TP3, TP4, TP5, TP6, TP7, TP8, TP9, TP10, TP11, TP12, TP13, TP14, TP15, TP16, TP17, TP18, TP19, TP20, TP21, TP22, TP23, TP24, TP25, TP26, TP27, TP28, TP29, TP30, TP31, TP32: TestPoint; TestPoint_THTPad_D2.0mm_Drill1.0mm
U1: 24LC08; DIP-8_W7.62mm_Socket
U2: NIS5132xx; DFN-10-1EP_3x3mm_P0.5mm_EP1.75x2.7mm
U3: uA7805; TO-220-3_Horizontal_TabDown
U4, U5, U6, U7, U8: 75ALS192; SOIC-16_3.9x9.9mm_P1.27mm

Connections:
+3V: A1.P2_5 (3V_55), A1.P2_6 (3V_56), C2.1, D6.5 (K)
+5V: A1.P2_3 (5V_53), A1.P2_4 (5V_54), C5.1, C6.1, C7.1, C8.2, C9.2, C12.1, C13.1, C14.1, C15.2, C16.2, C17.2, D10.5 (K), D11.5 (K), D12.5 (K), D13.5 (K), D14.5 (K), D15.5 (K), D16.5 (K), D17.5 (K), D18.5 (K), D19.5 (K), D21.2 (A), F2.2, F3.2, F4.2, F5.2, JP7.2 (B), TP32.1, U3.3 (OUT), U4.16 (VCC), U5.16 (VCC), U6.16 (VCC), U7.16 (VCC), U8.16 (VCC); also elsewhere on the board
+12V: F1.2, JP5.2 (B), R15.2, TP30.1, U2.6 (OUT), U2.7 (OUT), U2.8 (OUT), U2.9 (OUT), U2.10 (OUT)
/DB_BLUE: A1.P1_47 (PD15), D7.2 (A), TP15.1
/DB_GREEN: A1.P1_44 (PD12), D1.2 (A), TP12.1
/DB_ORANGE: A1.P1_45 (PD13), D4.2 (A), TP13.1
/DB_RED: A1.P1_46 (PD14), D5.2 (A), TP14.1
/DB_SYNC_0: A1.P2_36 (PD0), D8.2 (A), TP16.1
/DB_SYNC_1: A1.P2_33 (PD1), D9.2 (A), TP17.1
/DB_SYNC_2: A1.P2_34 (PD2), TP18.1
/DB_SYNC_3: A1.P2_31 (PD3), TP19.1
/I2C_SCL: A1.P2_43 (PA8), R12.1, TP11.1, U1.6 (SCL)
/I2C_SDA: A1.P2_46 (PC9), R10.1, TP10.1, U1.5 (SDA)
/MEM_PWR: A1.P2_47 (PC6), C3.1, R10.2, R12.2, U1.8 (VCC)
/MEM_WP: A1.P2_48 (PC7), TP7.1, U1.7 (WP)
/NRST: A1.P1_6 (NRST)
/PWM_CAP_1: A1.P1_37 (PB13), U4.7 (2A)
/PWM_CAP_1_N: CN6.4, CN10.5, D10.3 (K), R25.2
/PWM_CAP_1_P: CN6.3, CN10.4, D10.1 (K), R17.2
/PWM_CAP_2: A1.P2_20 (PB9), U5.15 (4A)
/PWM_CAP_2_N: CN9.4, CN13.5, D13.3 (K), R31.2
/PWM_CAP_2_P: CN9.3, CN13.4, D13.1 (K), R23.2
/PWM_CAP_A: A1.P2_19 (PB8), U5.7 (2A)
/PWM_CAP_A_N: CN8.4, CN12.5, D12.3 (K), R29.2
/PWM_CAP_A_P: CN8.3, CN12.4, D12.1 (K), R21.2
/PWM_CAP_B: A1.P1_39 (PB15), U4.15 (4A)
/PWM_CAP_B_N: CN7.4, CN11.5, D11.3 (K), R27.2
/PWM_CAP_B_P: CN7.3, CN11.4, D11.1 (K), R19.2
/RX_DEBUG: A1.P1_13 (PA3), R7.2
/RX_DEBUG_S: CN4.4, D6.3 (K), R7.1
/RX_INPUT: A1.P1_35 (PB11), R6.2
/RX_INPUT_S: CN3.4, CN5.4, D6.1 (K), R6.1
/TX_DEBUG: A1.P1_14 (PA2), R4.1
/TX_DEBUG_S: CN4.5, D6.6 (K), R4.2
/TX_INPUT: A1.P1_34 (PB10), R3.1
/TX_INPUT_S: CN3.5, CN5.2, D6.4 (K), R3.2
/TX_PANEL_0: A1.P2_13 (PE4), U6.1 (1A)
/TX_PANEL_0_N: CN14.2, CN17.4, D14.6 (K), R44.2
/TX_PANEL_0_P: CN14.1, CN17.5, D14.4 (K), R32.2
/TX_PANEL_1: A1.P2_14 (PE5), U6.7 (2A)
/TX_PANEL_1_N: CN14.4, CN17.3, D14.3 (K), R45.2
/TX_PANEL_1_P: CN14.3, CN17.6, D14.1 (K), R33.2
/TX_PANEL_2: A1.P2_11 (PE6), U6.9 (3A)
/TX_PANEL_2_N: CN14.6, CN17.1, D15.6 (K), R46.2
/TX_PANEL_2_P: CN14.5, CN17.2, D15.4 (K), R34.2
/TX_PANEL_3: A1.P1_25 (PE7), U6.15 (4A)
/TX_PANEL_3_N: CN14.8, CN17.7, D15.3 (K), R47.2
/TX_PANEL_3_P: CN14.7, CN17.8, D15.1 (K), R35.2
/TX_PANEL_4: A1.P1_26 (PE8), U7.1 (1A)
/TX_PANEL_4_N: CN15.2, CN18.4, D16.6 (K), R48.2
/TX_PANEL_4_P: CN15.1, CN18.5, D16.4 (K), R36.2
/TX_PANEL_5: A1.P1_27 (PE9), U7.7 (2A)
/TX_PANEL_5_N: CN15.4, CN18.3, D16.3 (K), R49.2
/TX_PANEL_5_P: CN15.3, CN18.6, D16.1 (K), R37.2
/TX_PANEL_6: A1.P1_28 (PE10), U7.9 (3A)
/TX_PANEL_6_N: CN15.6, CN18.1, D17.6 (K), R50.2
/TX_PANEL_6_P: CN15.5, CN18.2, D17.4 (K), R38.2
/TX_PANEL_7: A1.P1_29 (PE11), U7.15 (4A)
/TX_PANEL_7_N: CN15.8, CN18.7, D17.3 (K), R51.2
/TX_PANEL_7_P: CN15.7, CN18.8, D17.1 (K), R39.2
/TX_STALK_1: A1.P2_17 (PE0), U4.1 (1A)
/TX_STALK_1_N: CN6.2, CN10.3, D10.6 (K), R24.2
/TX_STALK_1_P: CN6.1, CN10.2, D10.4 (K), R16.2
/TX_STALK_2: A1.P2_16 (PE3), U5.9 (3A)
/TX_STALK_2_N: CN9.2, CN13.3, D13.6 (K), R30.2
/TX_STALK_2_P: CN9.1, CN13.2, D13.4 (K), R22.2
/TX_STALK_A: A1.P2_15 (PE2), U5.1 (1A)
/TX_STALK_A_N: CN8.2, CN12.3, D12.6 (K), R28.2
/TX_STALK_A_P: CN8.1, CN12.2, D12.4 (K), R20.2
/TX_STALK_B: A1.P2_18 (PE1), U4.9 (3A)
/TX_STALK_B_N: CN7.2, CN11.3, D11.6 (K), R26.2
/TX_STALK_B_P: CN7.1, CN11.2, D11.4 (K), R18.2
/TX_XP_0: A1.P1_30 (PE12), U8.1 (1A)
/TX_XP_0_N: CN16.2, CN19.4, D18.6 (K), R52.2
/TX_XP_0_P: CN16.1, CN19.5, D18.4 (K), R40.2
/TX_XP_1: A1.P1_31 (PE13), U8.7 (2A)
/TX_XP_1_N: CN16.4, CN19.3, D18.3 (K), R53.2
/TX_XP_1_P: CN16.3, CN19.6, D18.1 (K), R41.2
/TX_XP_2: A1.P1_32 (PE14), U8.9 (3A)
/TX_XP_2_N: CN16.6, CN19.1, D19.6 (K), R54.2
/TX_XP_2_P: CN16.5, CN19.2, D19.4 (K), R42.2
/TX_XP_3: A1.P1_33 (PE15), U8.15 (4A)
/TX_XP_3_N: CN16.8, CN19.7, D19.3 (K), R55.2
/TX_XP_3_P: CN16.7, CN19.8, D19.1 (K), R43.2
GND: A1.P1_1 (GND_1), A1.P1_2 (GND_2), A1.P1_5 (GND_5), A1.P1_23 (GND_23), A1.P1_49 (GND_49), A1.P1_50 (GND_50), A1.P2_1 (GND_51), A1.P2_2 (GND_52), A1.P2_49 (GND_99), A1.P2_50 (GND_100), C1.2, C2.2, C3.2, C4.2, C5.2, C6.2, C7.2, C8.1, C9.1, C12.2, C13.2, C14.2, C15.1, C16.1, C17.1, CN1.2, CN2.2, CN3.1, CN4.1, CN5.1, CN5.3, CN5.5, CN5.6, CN10.6, CN11.6, CN12.6, CN13.6, CN17.SH, CN18.SH, CN19.SH, D3.2 (A), D6.2 (A), D10.2 (A), D11.2 (A), D12.2 (A), D13.2 (A), D14.2 (A), D15.2 (A), D16.2 (A), D17.2 (A), D18.2 (A), D19.2 (A), H1.1, H2.1, H3.1, H4.1, R2.1, R8.1, R9.1, R11.1, R13.1, R14.1, R57.1, R58.1, TP1.1, TP2.1, TP3.1, TP4.1, TP5.1, TP8.1, TP9.1, TP20.1, TP21.1, TP22.1, TP23.1, TP24.1, TP25.1, TP26.1, TP27.1, TP28.1, TP29.1, U1.1 (A0), U1.2 (A1), U1.3 (A2), U1.4 (GND), U2.1 (GND), U3.2 (GND), U4.4 (G), U4.8 (VSS), U4.12 (#G), U5.4 (G), U5.8 (VSS), U5.12 (#G), U6.4 (G), U6.8 (VSS), U6.12 (#G), U7.4 (G), U7.8 (VSS), U7.12 (#G), U8.4 (G), U8.8 (VSS), U8.12 (#G); also elsewhere on the board
unnamed: C1.1, CN1.1, CN2.1, D3.1 (K), JP5.1 (A), R56.1, TP6.1, U2.11 (VIN)
unnamed 135: C4.1, D20.2 (A), F1.1, JP7.1 (A), TP31.1, U3.1 (IN); also elsewhere on the board
unnamed: CN1.3, R56.2
unnamed: CN10.1, F2.1
unnamed: CN11.1, F3.1
unnamed: CN12.1, F4.1
unnamed: CN13.1, F5.1
unnamed: D1.1 (K), R2.2
unnamed: D4.1 (K), R8.2
unnamed: D5.1 (K), R9.2
unnamed: D7.1 (K), R11.2
unnamed: D8.1 (K), R13.2
unnamed: D9.1 (K), R14.2
unnamed: D20.1 (K), R57.2
unnamed: D21.1 (K), R58.2
unnamed: R15.1, U2.4 (ILIM)
unnamed: R16.1, U4.2 (1Y)
unnamed: R17.1, U4.6 (2Y)
unnamed: R18.1, U4.10 (3Y)
unnamed: R19.1, U4.14 (4Y)
unnamed: R20.1, U5.2 (1Y)
unnamed: R21.1, U5.6 (2Y)
unnamed: R22.1, U5.10 (3Y)
unnamed: R23.1, U5.14 (4Y)
unnamed: R24.1, U4.3 (1Z)
unnamed: R25.1, U4.5 (2Z)
unnamed: R26.1, U4.11 (3Z)
unnamed: R27.1, U4.13 (4Z)
unnamed: R28.1, U5.3 (1Z)
unnamed: R29.1, U5.5 (2Z)
unnamed: R30.1, U5.11 (3Z)
unnamed: R31.1, U5.13 (4Z)
unnamed: R32.1, U6.2 (1Y)
unnamed: R33.1, U6.6 (2Y)
unnamed: R34.1, U6.10 (3Y)
unnamed: R35.1, U6.14 (4Y)
unnamed: R36.1, U7.2 (1Y)
unnamed: R37.1, U7.6 (2Y)
unnamed: R38.1, U7.10 (3Y)
unnamed: R39.1, U7.14 (4Y)
unnamed: R40.1, U8.2 (1Y)
unnamed: R41.1, U8.6 (2Y)
unnamed: R42.1, U8.10 (3Y)
unnamed: R43.1, U8.14 (4Y)
unnamed: R44.1, U6.3 (1Z)
unnamed: R45.1, U6.5 (2Z)
unnamed: R46.1, U6.11 (3Z)
unnamed: R47.1, U6.13 (4Z)
unnamed: R48.1, U7.3 (1Z)
unnamed: R49.1, U7.5 (2Z)
unnamed: R50.1, U7.11 (3Z)
unnamed: R51.1, U7.13 (4Z)
unnamed: R52.1, U8.3 (1Z)
unnamed: R53.1, U8.5 (2Z)
unnamed: R54.1, U8.11 (3Z)
unnamed: R55.1, U8.13 (4Z)

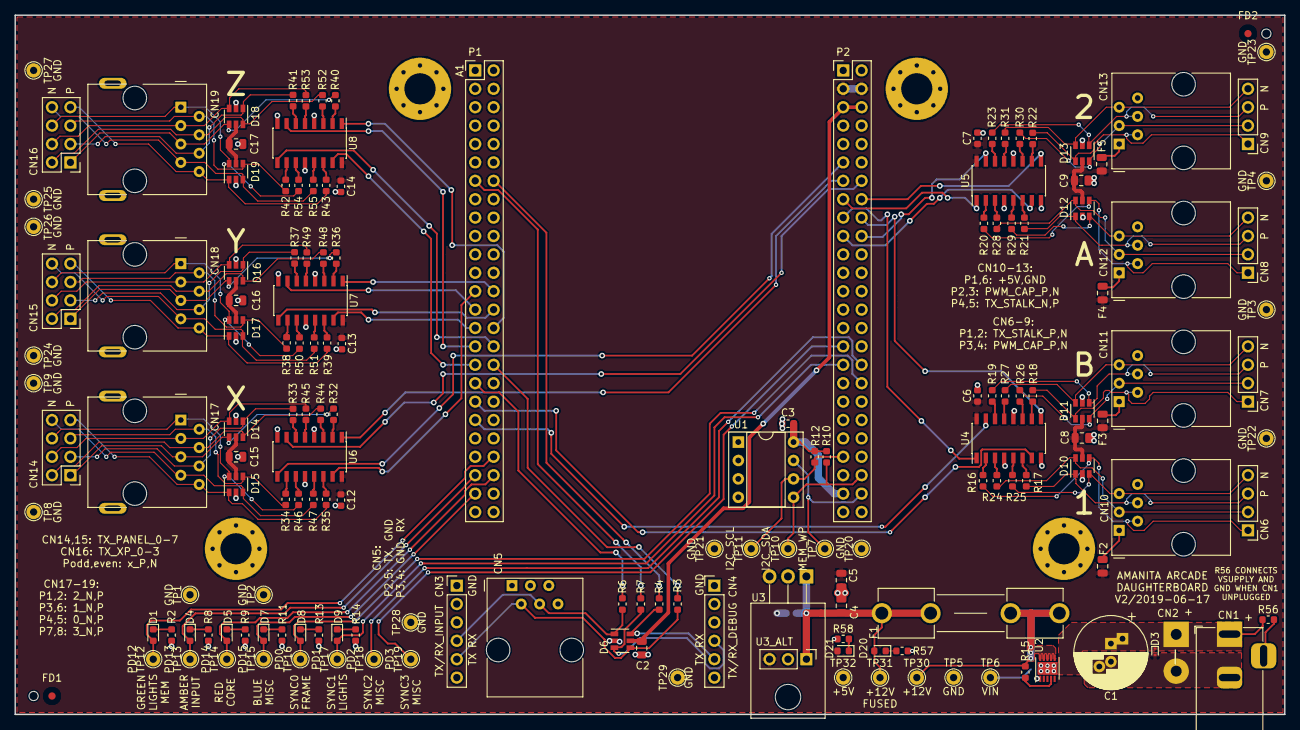
[picture p11: board aa-daughterboard-lvds.kicad_pcb from above]

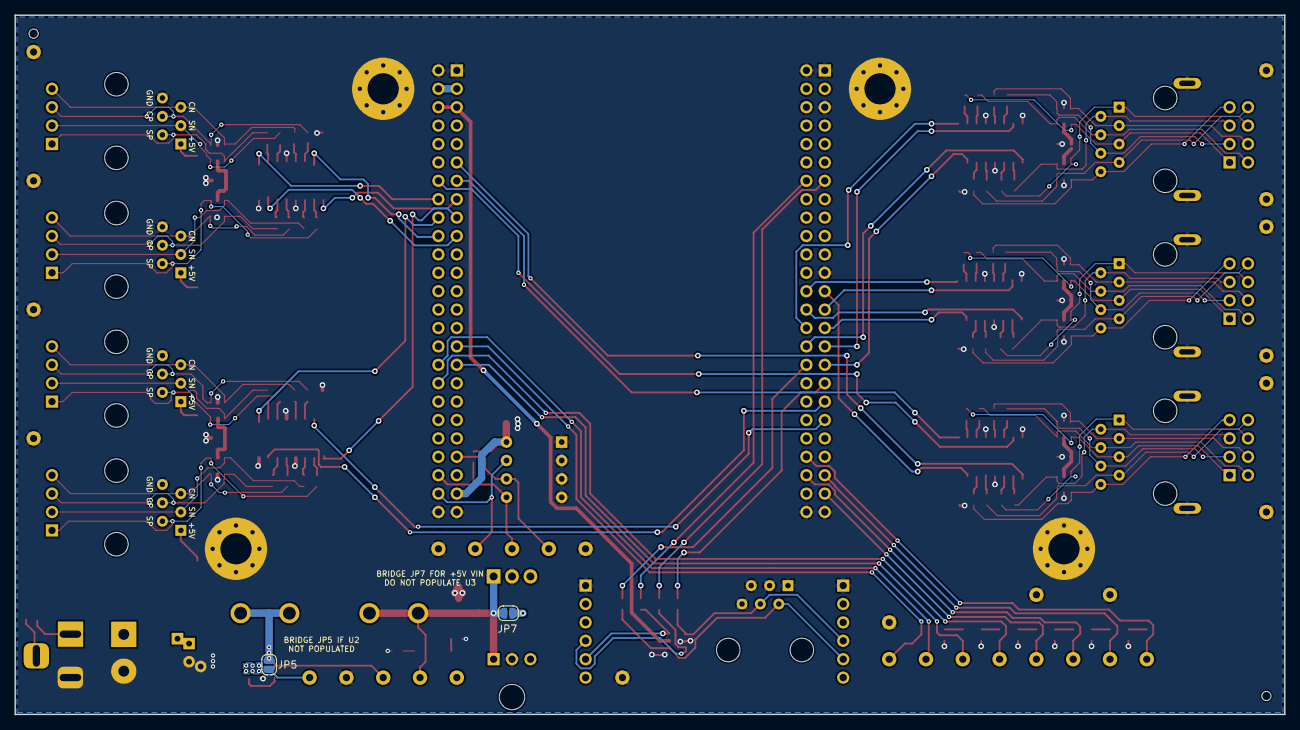
[picture p12: board aa-daughterboard-lvds.kicad_pcb from below]

Board: 4 copper layers, 175.3 x 96.5 mm, 167 parts (2 on the bottom side), 140 nets.

Other parts of the board:
FD1, FD2: Fiducial_1mm_Dia_2.54mm_Outer_CopperTop
FD5, FD6: StencilAlignment_1.27mm
U3_ALT: PinHeader_1x03_P2.54mm_Vertical

Their connections:
+5V: U3_ALT.3; also elsewhere on the board
GND: U3_ALT.2; also elsewhere on the board
unnamed 135: U3_ALT.1; also elsewhere on the board
