jlunder/amanita-arcade/hardware/aa-input-controller/aa-input-controller.kicad_pcb

## KiCad design hardware/aa-input-controller/aa-input-controller.kicad_pcb (2019-08-07)

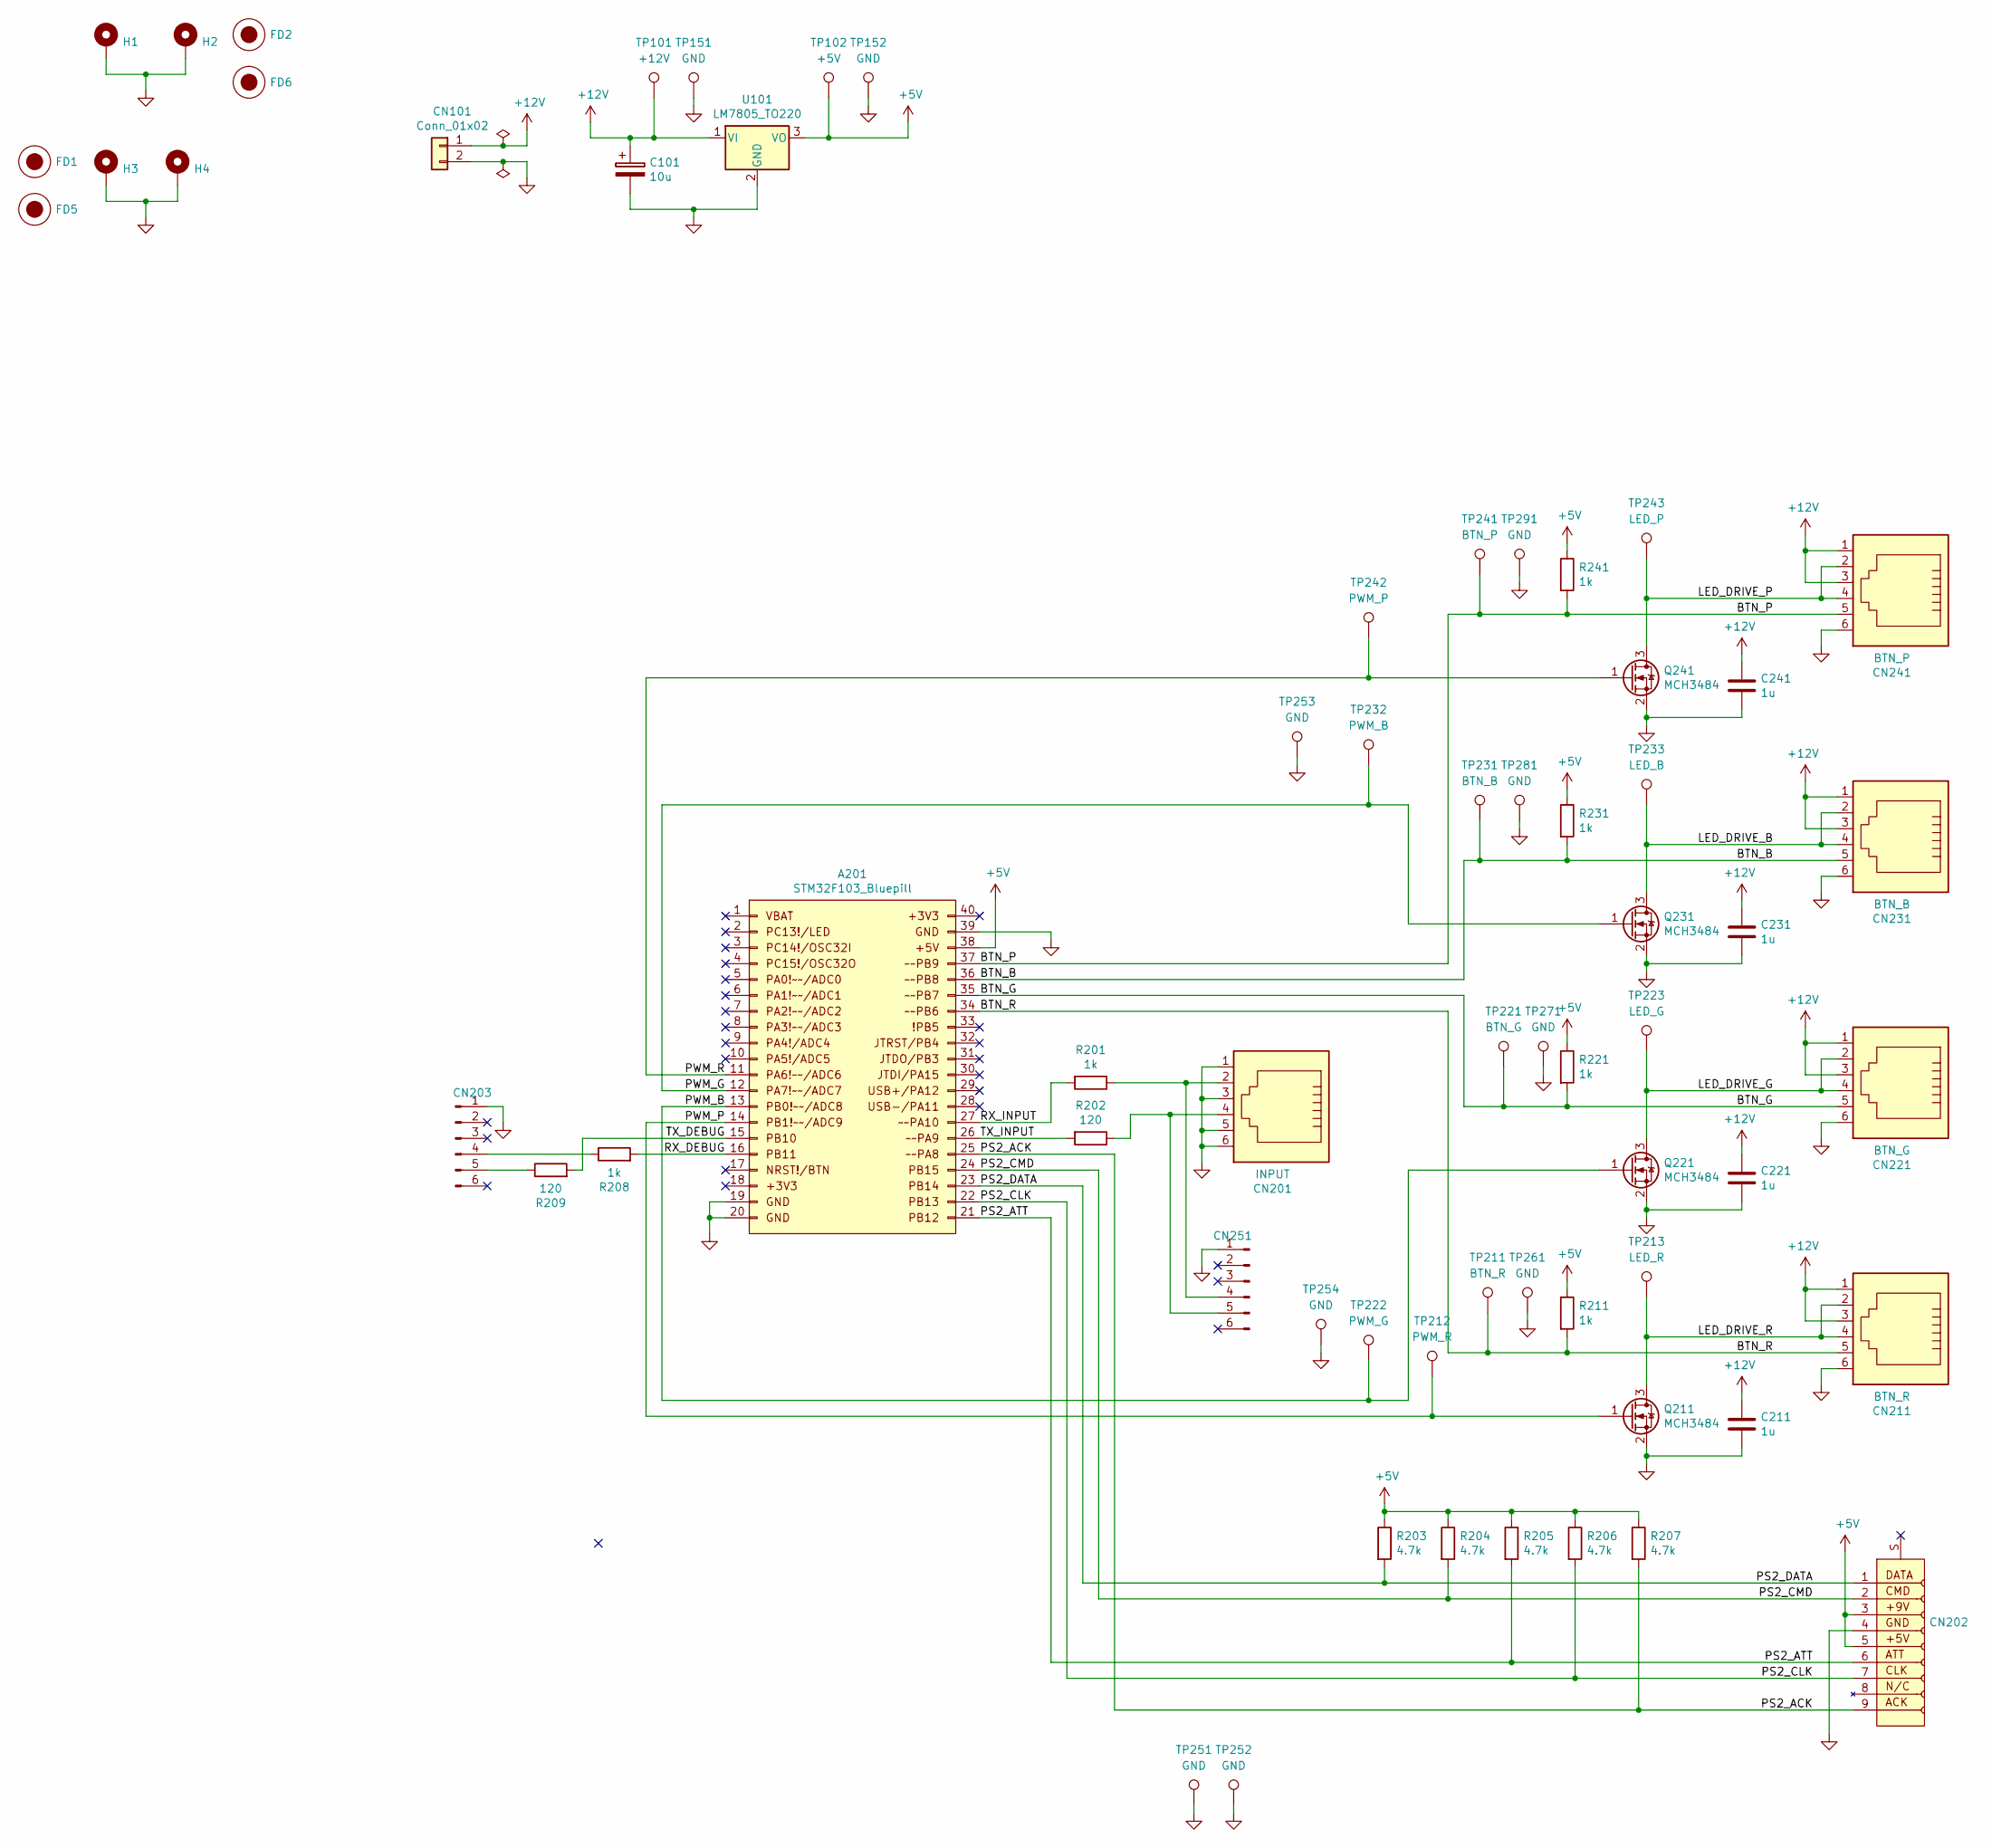
[picture p13: schematic aa-input-controller.sch]

Parts:
A201: STM32F103_Bluepill; Maple_Mini
C101: 10u; CP_Radial_D10.0mm_P2.50mm_P5.00mm
C211, C221, C231, C241: 1u; C_0805_2012Metric
CN101: Conn_01x02; SolderWirePad_1x02_P5.08mm_Drill1.5mm
CN201: INPUT; 6P6C_Assmann_A-2014-1-4
CN202: Connector_Sony_Playstation_DualShock_Female; Connector_SonyPS2DualShock_Female
CN203, CN251: Conn_01x06_Male; PinHeader_1x06_P2.54mm_Vertical
CN211: BTN_R; 6P6C_Assmann_A-2014-1-4
CN221: BTN_G; 6P6C_Assmann_A-2014-1-4
CN231: BTN_B; 6P6C_Assmann_A-2014-1-4
CN241: BTN_P; 6P6C_Assmann_A-2014-1-4
FD1, FD2: Fiducial; Fiducial_1mm_Dia_2.54mm_Outer_CopperTop
FD5, FD6: Fiducial; StencilAlignment_1.27mm
H1, H2, H3, H4: MountingHole_Pad; MountingHole_2.7mm_M2.5_Pad_Via
Q211, Q221, Q231, Q241: MCH3484; SOT-323_SC-70
R201, R208, R211, R221, R231, R241: 1k; R_0603_1608Metric
R202, R209: 120; R_0603_1608Metric
R203, R204, R205, R206, R207: 4.7k; R_0603_1608Metric
TP101: +12V; TestPoint_Loop_D1.80mm_Drill1.0mm_Beaded
TP102: +5V; TestPoint_Loop_D1.80mm_Drill1.0mm_Beaded
TP151, TP152, TP251, TP252, TP253, TP254, TP261, TP271, TP281, TP291: GND; TestPoint_Loop_D1.80mm_Drill1.0mm_Beaded
TP211: BTN_R; TestPoint_Loop_D1.80mm_Drill1.0mm_Beaded
TP212: PWM_R; TestPoint_Loop_D1.80mm_Drill1.0mm_Beaded
TP213: LED_R; TestPoint_Loop_D1.80mm_Drill1.0mm_Beaded
TP221: BTN_G; TestPoint_Loop_D1.80mm_Drill1.0mm_Beaded
TP222: PWM_G; TestPoint_Loop_D1.80mm_Drill1.0mm_Beaded
TP223: LED_G; TestPoint_Loop_D1.80mm_Drill1.0mm_Beaded
TP231: BTN_B; TestPoint_Loop_D1.80mm_Drill1.0mm_Beaded
TP232: PWM_B; TestPoint_Loop_D1.80mm_Drill1.0mm_Beaded
TP233: LED_B; TestPoint_Loop_D1.80mm_Drill1.0mm_Beaded
TP241: BTN_P; TestPoint_Loop_D1.80mm_Drill1.0mm_Beaded
TP242: PWM_P; TestPoint_Loop_D1.80mm_Drill1.0mm_Beaded
TP243: LED_P; TestPoint_Loop_D1.80mm_Drill1.0mm_Beaded
U101: LM7805_TO220; TO-220-3_Horizontal_TabDown

Connections:
+5V: A201.38, CN202.3, CN202.5, R203.1, R204.1, R205.1, R206.1, R207.1, R211.1, R221.1, R231.1, R241.1, TP102.1, U101.3 (VO)
+12V: C101.1, C211.1, C221.1, C231.1, C241.1, CN101.1, CN211.1, CN211.3, CN221.1, CN221.3, CN231.1, CN231.3, CN241.1, CN241.3, TP101.1, U101.1 (VI)
/BTN_B: A201.36, CN231.5, R231.2, TP231.1
/BTN_G: A201.35, CN221.5, R221.2, TP221.1
/BTN_P: A201.37, CN241.5, R241.2, TP241.1
/BTN_R: A201.34, CN211.5, R211.2, TP211.1
/LED_DRIVE_B: CN231.2, CN231.4, Q231.3 (D), TP233.1
/LED_DRIVE_G: CN221.2, CN221.4, Q221.3 (D), TP223.1
/LED_DRIVE_P: CN241.2, CN241.4, Q241.3 (D), TP243.1
/LED_DRIVE_R: CN211.2, CN211.4, Q211.3 (D), TP213.1
/PS2_ACK: A201.25, CN202.9, R207.2
/PS2_ATT: A201.21, CN202.6, R205.2
/PS2_CLK: A201.22, CN202.7, R206.2
/PS2_CMD: A201.24, CN202.2, R204.2
/PS2_DATA: A201.23, CN202.1, R203.2
/PWM_B: A201.13, Q221.1 (G), TP222.1
/PWM_G: A201.12, Q231.1 (G), TP232.1
/PWM_P: A201.14, Q211.1 (G), TP212.1
/PWM_R: A201.11, Q241.1 (G), TP242.1
/RX_DEBUG: A201.16, R208.2
/RX_INPUT: A201.27, R201.2
/TX_DEBUG: A201.15, R209.2
/TX_INPUT: A201.26, R202.2
GND: A201.19, A201.20, A201.39, C101.2, C211.2, C221.2, C231.2, C241.2, CN101.2, CN201.1, CN201.3, CN201.5, CN201.6, CN202.4, CN203.1, CN211.6, CN221.6, CN231.6, CN241.6, CN251.1, H1.1, H2.1, H3.1, H4.1, Q211.2 (S), Q221.2 (S), Q231.2 (S), Q241.2 (S), TP151.1, TP152.1, TP251.1, TP252.1, TP253.1, TP254.1, TP261.1, TP271.1, TP281.1, TP291.1, U101.2 (GND)
unnamed: CN201.2, CN251.4, R201.1
unnamed: CN201.4, CN251.5, R202.1
unnamed: CN203.4, R208.1
unnamed: CN203.5, R209.1

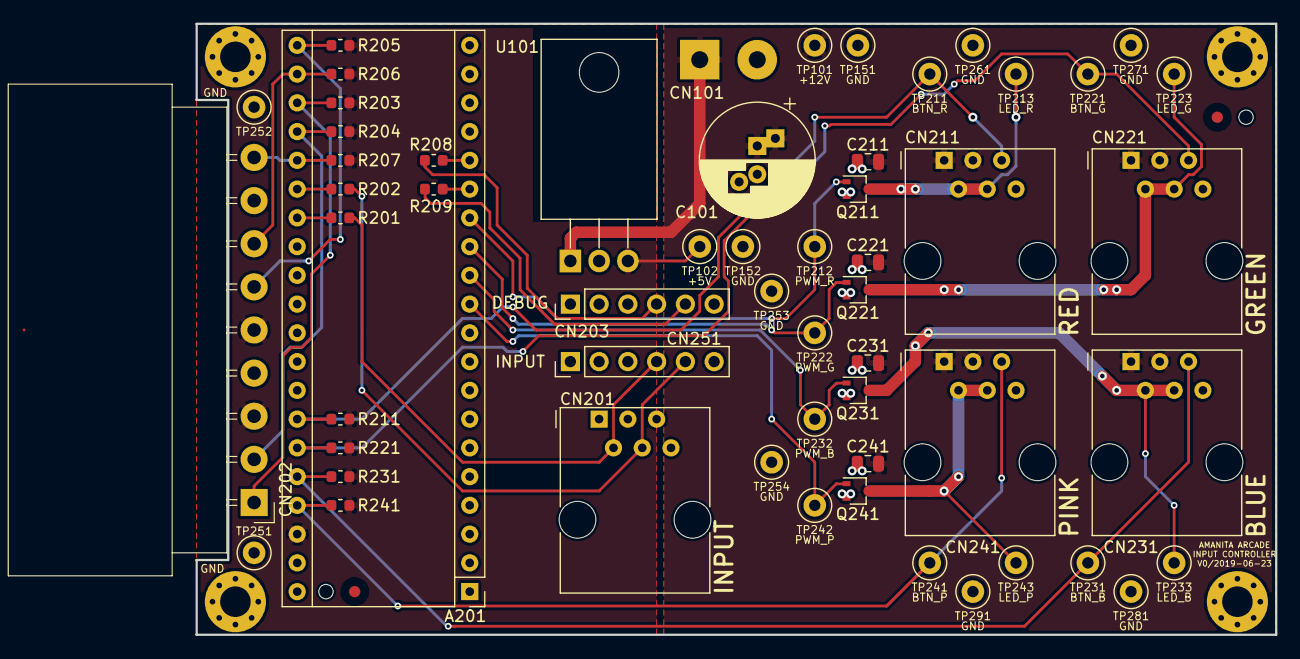
[picture p14: board aa-input-controller.kicad_pcb from above]

Board: 2 copper layers, 95.4 x 54.0 mm, 65 parts (0 on the bottom side), 28 nets.
