jlunder/amanita-arcade/hardware/aa-panel-receiver-lvds/aa-panel-receiver-lvds.kicad_pcb

## KiCad design hardware/aa-panel-receiver-lvds/aa-panel-receiver-lvds.kicad_pcb (2019-08-07)

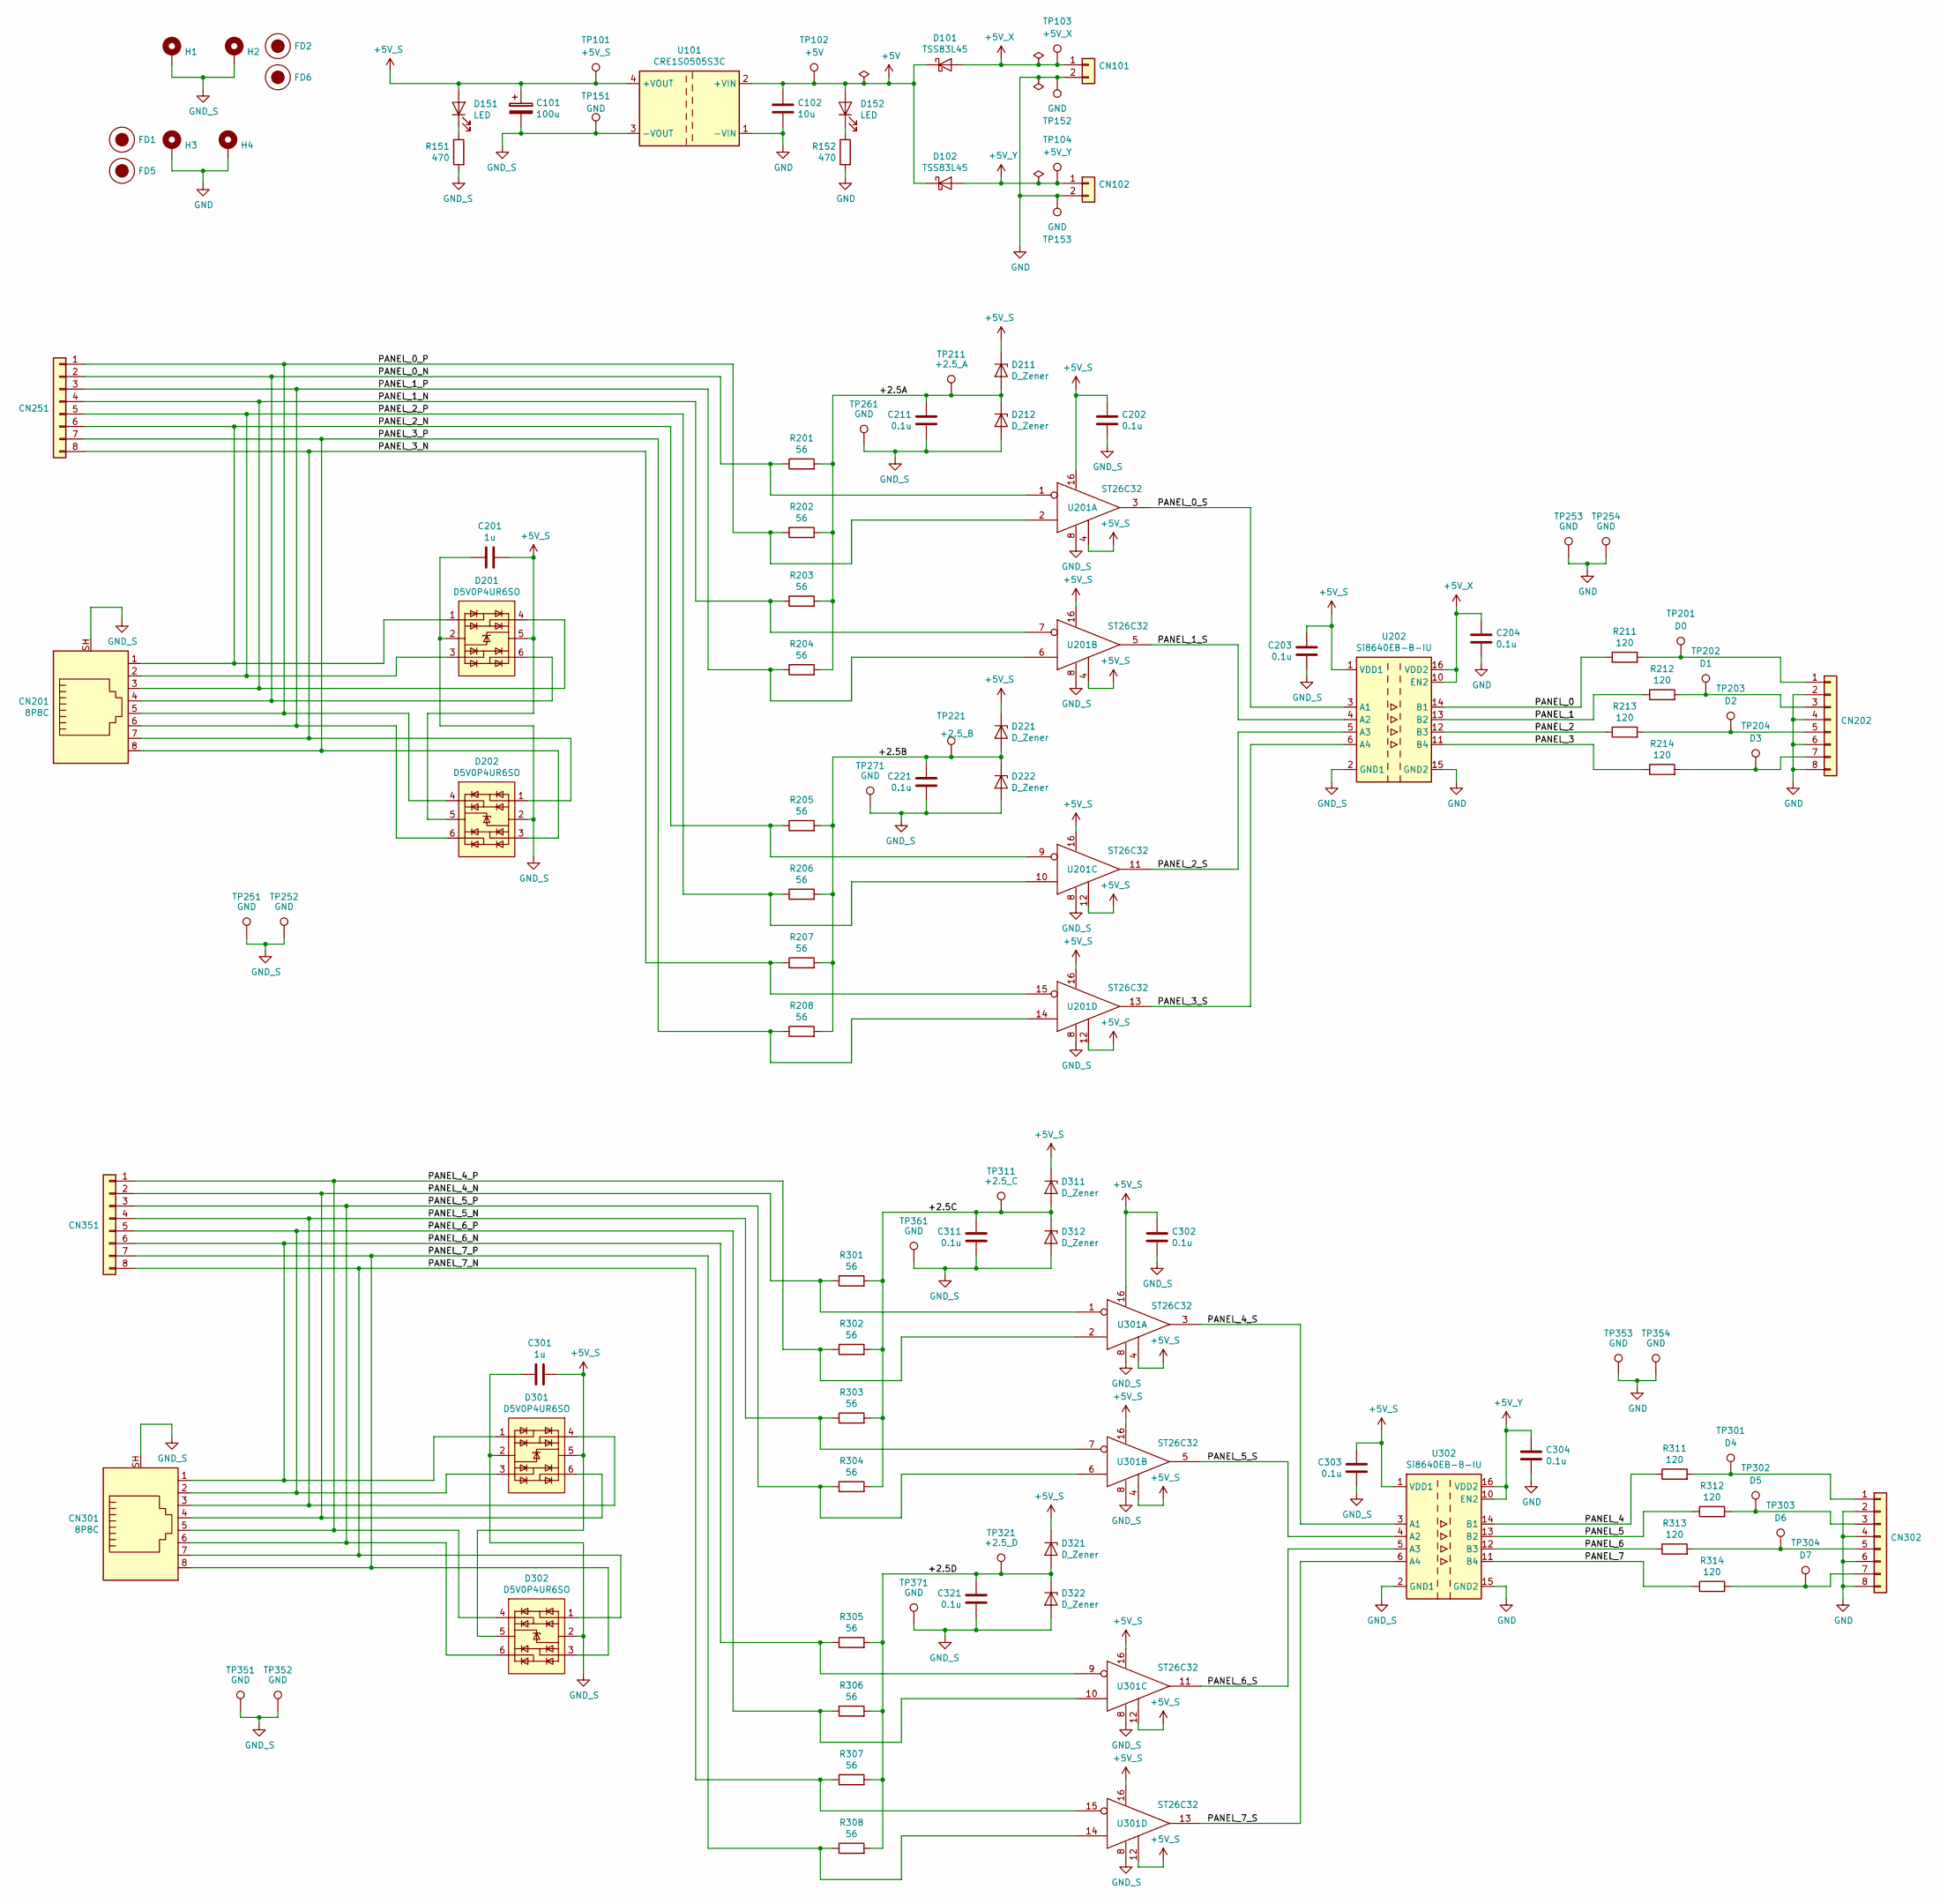
[picture p15: schematic aa-panel-receiver-lvds.sch]

Parts:
C101: 100u; CP_Radial_D10.0mm_P2.50mm_P5.00mm
C102: 10u; CP_Radial_D6.3mm_P2.50mm
C201, C301: 1u; C_0805_2012Metric
C202, C203, C204, C211, C221, C302, C303, C304, C311, C321: 0.1u; C_0603_1608Metric
CN101, CN102: Conn_01x02; SolderWirePad_1x02_P5.08mm_Drill1.5mm
CN201, CN301: 8P8C; 8P8C_Assmann_A-2014-2S-4
CN202, CN251, CN302, CN351: Conn_01x08; PinHeader_2x04_P2.54mm_Vertical
D101, D102: TSS83L45; D_SOD-128
D151, D152: LED; LED_0603_1608Metric
D201, D202, D301, D302: D5V0P4UR6SO; SOT-23-6
D211, D212, D221, D222, D311, D312, D321, D322: D_Zener; D_DO-35_SOD27_P2.54mm_Vertical_KathodeUp
FD1, FD2: Fiducial; Fiducial_1mm_Dia_2.54mm_Outer_CopperTop
FD5, FD6: Fiducial; StencilAlignment_1.27mm
H1, H2, H3, H4: MountingHole_Pad; MountingHole_2.7mm_M2.5_Pad_Via
R151, R152: 470; R_0603_1608Metric
R201, R202, R203, R204, R205, R206, R207, R208, R301, R302, R303, R304, R305, R306, R307, R308: 56; R_0603_1608Metric
R211, R212, R213, R214, R311, R312, R313, R314: 120; R_0603_1608Metric
TP101: +5V_S; TestPoint_Loop_D1.80mm_Drill1.0mm_Beaded
TP102: +5V; TestPoint_Loop_D1.80mm_Drill1.0mm_Beaded
TP103: +5V_X; TestPoint_Loop_D1.80mm_Drill1.0mm_Beaded
TP104: +5V_Y; TestPoint_Loop_D1.80mm_Drill1.0mm_Beaded
TP151, TP152, TP153, TP251, TP252, TP253, TP254, TP261, TP271, TP351, TP352, TP353, TP354, TP361, TP371: GND; TestPoint_Loop_D1.80mm_Drill1.0mm_Beaded
TP201: D0; TestPoint_Loop_D1.80mm_Drill1.0mm_Beaded
TP202: D1; TestPoint_Loop_D1.80mm_Drill1.0mm_Beaded
TP203: D2; TestPoint_Loop_D1.80mm_Drill1.0mm_Beaded
TP204: D3; TestPoint_Loop_D1.80mm_Drill1.0mm_Beaded
TP211: +2.5_A; TestPoint_Loop_D1.80mm_Drill1.0mm_Beaded
TP221: +2.5_B; TestPoint_Loop_D1.80mm_Drill1.0mm_Beaded
TP301: D4; TestPoint_Loop_D1.80mm_Drill1.0mm_Beaded
TP302: D5; TestPoint_Loop_D1.80mm_Drill1.0mm_Beaded
TP303: D6; TestPoint_Loop_D1.80mm_Drill1.0mm_Beaded
TP304: D7; TestPoint_Loop_D1.80mm_Drill1.0mm_Beaded
TP311: +2.5_C; TestPoint_Loop_D1.80mm_Drill1.0mm_Beaded
TP321: +2.5_D; TestPoint_Loop_D1.80mm_Drill1.0mm_Beaded
U101: CRE1S0505S3C; Converter_DCDC_muRata_CRE1xxxxxx3C_THT
U201, U301: ST26C32; SOIC-16_3.9x9.9mm_P1.27mm
U202, U302: Si8640EB-B-IU; QSOP-16_3.9x4.9mm_P0.635mm

Connections:
+5V: C102.1, D101.1 (K), D102.1 (K), D152.2 (A), TP102.1, U101.2 (+VIN)
+5V_S: C101.1, C201.1, C202.1, C203.1, C301.1, C302.1, C303.1, D151.2 (A), D201.5 (K), D202.5 (K), D211.1 (K), D221.1 (K), D301.5 (K), D302.5 (K), D311.1 (K), D321.1 (K), TP101.1, U101.4 (+VOUT), U201.4 (ENABLE), U201.12 (ENABLE), U201.16 (VCC), U202.1 (VDD1), U301.4 (ENABLE), U301.12 (ENABLE), U301.16 (VCC), U302.1 (VDD1)
+5V_X: C204.1, CN101.1, D101.2 (A), TP103.1, U202.10 (EN2), U202.16 (VDD2)
+5V_Y: C304.1, CN102.1, D102.2 (A), TP104.1, U302.10 (EN2), U302.16 (VDD2)
/+2.5A: C211.1, D211.2 (A), D212.1 (K), R201.2, R202.2, R203.2, R204.2, TP211.1
/+2.5B: C221.1, D221.2 (A), D222.1 (K), R205.2, R206.2, R207.2, R208.2, TP221.1
/+2.5C: C311.1, D311.2 (A), D312.1 (K), R301.2, R302.2, R303.2, R304.2, TP311.1
/+2.5D: C321.1, D321.2 (A), D322.1 (K), R305.2, R306.2, R307.2, R308.2, TP321.1
/PANEL_0: R211.1, U202.14 (B1)
/PANEL_0_N: CN201.4, CN251.2, D201.6 (K), R201.1, U201.1 (E-)
/PANEL_0_P: CN201.5, CN251.1, D202.4 (K), R202.1, U201.2 (E+)
/PANEL_0_S: U201.3 (OUT), U202.3 (A1)
/PANEL_1: R212.1, U202.13 (B2)
/PANEL_1_N: CN201.3, CN251.4, D201.4 (K), R203.1, U201.7 (E-)
/PANEL_1_P: CN201.6, CN251.3, D202.6 (K), R204.1, U201.6 (E+)
/PANEL_1_S: U201.5 (OUT), U202.4 (A2)
/PANEL_2: R213.1, U202.12 (B3)
/PANEL_2_N: CN201.1, CN251.6, D201.1 (K), R205.1, U201.9 (E-)
/PANEL_2_P: CN201.2, CN251.5, D201.3 (K), R206.1, U201.10 (E+)
/PANEL_2_S: U201.11 (OUT), U202.5 (A3)
/PANEL_3: R214.1, U202.11 (B4)
/PANEL_3_N: CN201.7, CN251.8, D202.1 (K), R207.1, U201.15 (E-)
/PANEL_3_P: CN201.8, CN251.7, D202.3 (K), R208.1, U201.14 (E+)
/PANEL_3_S: U201.13 (OUT), U202.6 (A4)
/PANEL_4: R311.1, U302.14 (B1)
/PANEL_4_N: CN301.4, CN351.2, D301.6 (K), R301.1, U301.1 (E-)
/PANEL_4_P: CN301.5, CN351.1, D302.4 (K), R302.1, U301.2 (E+)
/PANEL_4_S: U301.3 (OUT), U302.3 (A1)
/PANEL_5: R312.1, U302.13 (B2)
/PANEL_5_N: CN301.3, CN351.4, D301.4 (K), R303.1, U301.7 (E-)
/PANEL_5_P: CN301.6, CN351.3, D302.6 (K), R304.1, U301.6 (E+)
/PANEL_5_S: U301.5 (OUT), U302.4 (A2)
/PANEL_6: R313.1, U302.12 (B3)
/PANEL_6_N: CN301.1, CN351.6, D301.1 (K), R305.1, U301.9 (E-)
/PANEL_6_P: CN301.2, CN351.5, D301.3 (K), R306.1, U301.10 (E+)
/PANEL_6_S: U301.11 (OUT), U302.5 (A3)
/PANEL_7: R314.1, U302.11 (B4)
/PANEL_7_N: CN301.7, CN351.8, D302.1 (K), R307.1, U301.15 (E-)
/PANEL_7_P: CN301.8, CN351.7, D302.3 (K), R308.1, U301.14 (E+)
/PANEL_7_S: U301.13 (OUT), U302.6 (A4)
GND: C102.2, C204.2, C304.2, CN101.2, CN102.2, CN202.2, CN202.4, CN202.6, CN202.8, CN302.2, CN302.4, CN302.6, CN302.8, H3.1, H4.1, R152.2, TP152.1, TP153.1, TP253.1, TP254.1, TP353.1, TP354.1, U101.1 (-VIN), U202.9 (GND2), U202.15 (GND2), U302.9 (GND2), U302.15 (GND2)
GND_S: C101.2, C201.2, C202.2, C203.2, C211.2, C221.2, C301.2, C302.2, C303.2, C311.2, C321.2, CN201.SH, CN301.SH, D201.2 (A), D202.2 (A), D212.2 (A), D222.2 (A), D301.2 (A), D302.2 (A), D312.2 (A), D322.2 (A), H1.1, H2.1, R151.2, TP151.1, TP251.1, TP252.1, TP261.1, TP271.1, TP351.1, TP352.1, TP361.1, TP371.1, U101.3 (-VOUT), U201.8 (GND), U202.2 (GND1), U202.8 (GND1), U301.8 (GND), U302.2 (GND1), U302.8 (GND1)
unnamed: CN202.1, R211.2, TP201.1
unnamed: CN202.3, R212.2, TP202.1
unnamed: CN202.5, R213.2, TP203.1
unnamed: CN202.7, R214.2, TP204.1
unnamed: CN302.1, R311.2, TP301.1
unnamed: CN302.3, R312.2, TP302.1
unnamed: CN302.5, R313.2, TP303.1
unnamed: CN302.7, R314.2, TP304.1
unnamed: D151.1 (K), R151.1
unnamed: D152.1 (K), R152.1

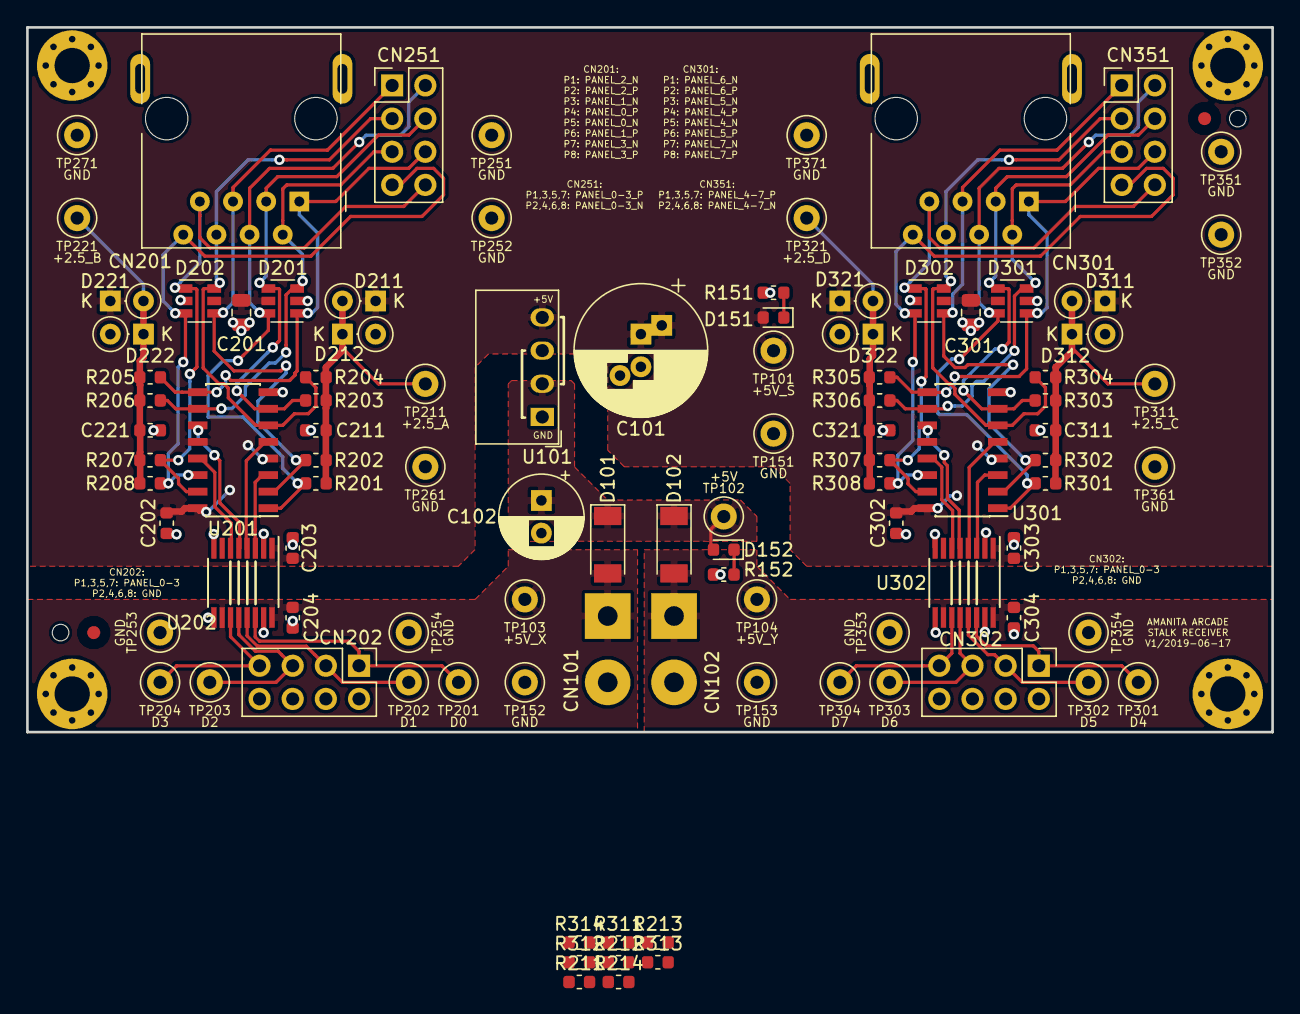
[picture p16: board aa-panel-receiver-lvds.kicad_pcb from above]

Board: 2 copper layers, 95.4 x 54.0 mm, 108 parts (0 on the bottom side), 52 nets.
