jlunder/amanita-arcade/hardware/aa-power/aa-power.kicad_pcb

## KiCad design hardware/aa-power/aa-power.kicad_pcb (2019-06-22)

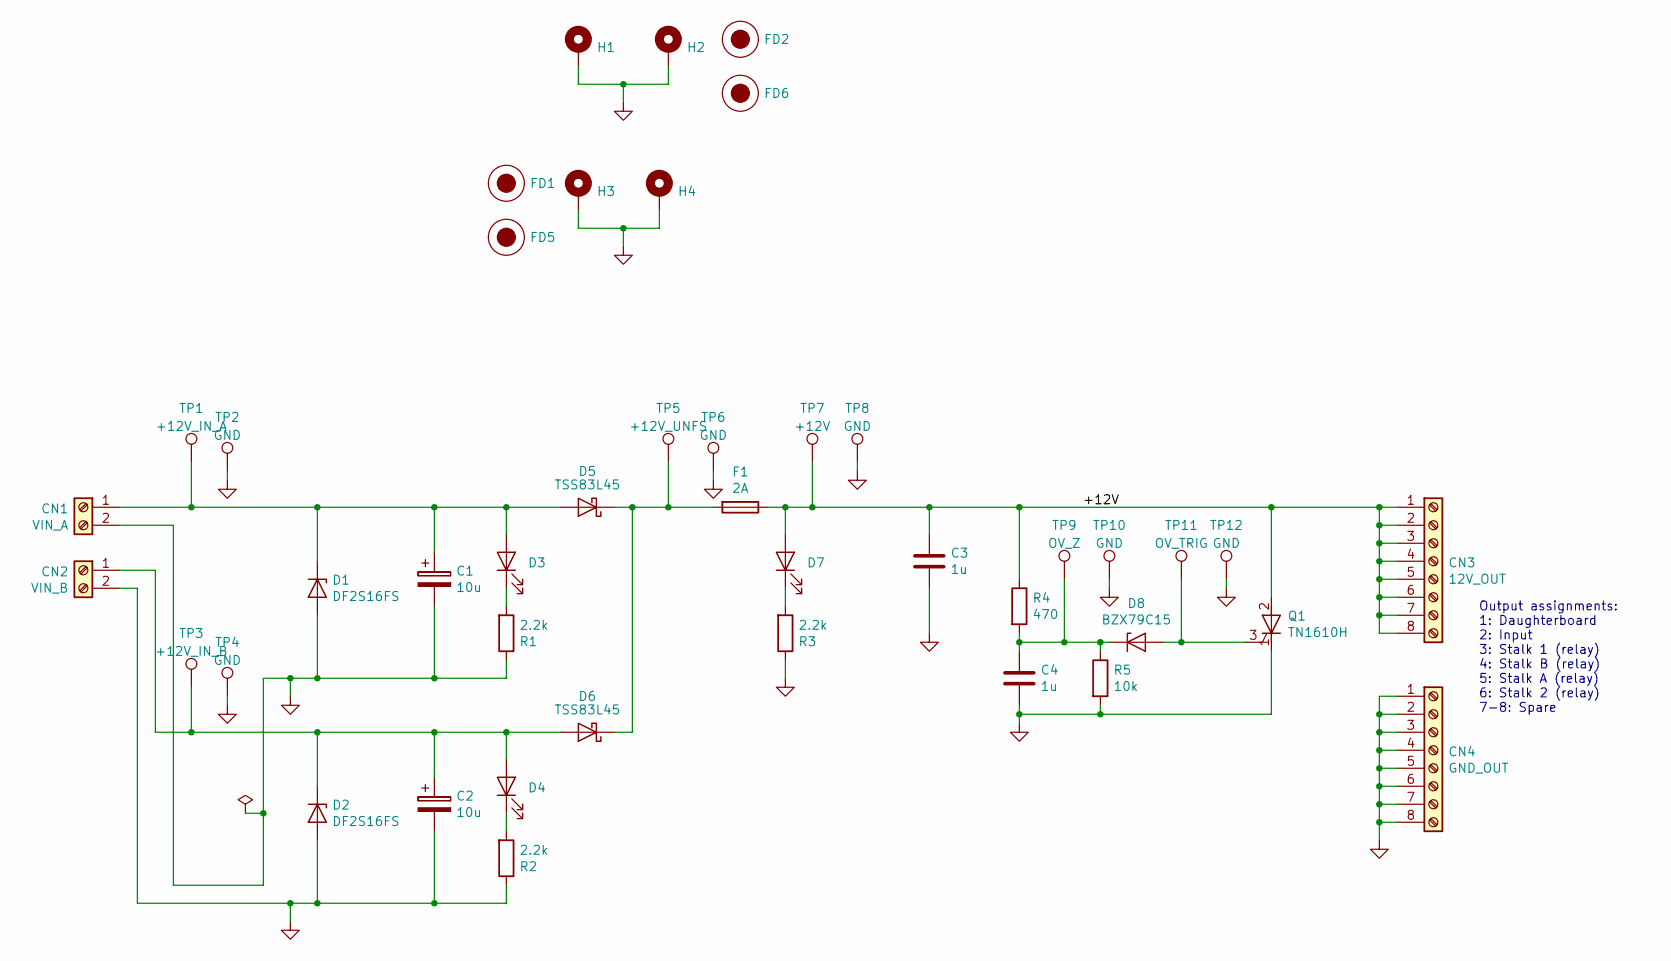
[picture p17: schematic aa-power.sch]

Parts:
C1, C2: 10u; CP_Radial_D5.0mm_P2.50mm
C3, C4: 1u; C_0805_2012Metric
CN1: VIN_A; SolderWirePad_1x02_P5.08mm_Drill1.5mm
CN2: VIN_B; SolderWirePad_1x02_P5.08mm_Drill1.5mm
CN3: 12V_OUT; TerminalBlock_OST_OSTYK44108030
CN4: GND_OUT; TerminalBlock_OST_OSTYK44108030
D1, D2: DF2S16FS; D_SOD-923
D3, D4, D7: LED; LED_0603_1608Metric
D5, D6: TSS83L45; D_SOD-128
D8: BZX79C15; D_DO-35_SOD27_P2.54mm_Vertical_KathodeUp
F1: 2A; Fuseholder_Clip_5x20_Bel_FC-211-22
FD1, FD2: Fiducial; Fiducial_1mm_Dia_2.54mm_Outer_CopperTop
FD5, FD6: Fiducial; StencilAlignment_1.27mm
H1, H2, H3, H4: MountingHole_Pad; MountingHole_2.7mm_M2.5_Pad_Via
Q1: TN1610H; TO-220-3_Horizontal_TabDown
R1, R2, R3: 2.2k; R_0603_1608Metric
R4: 470; R_0603_1608Metric
R5: 10k; R_0603_1608Metric
TP1: +12V_IN_A; TestPoint_Loop_D1.80mm_Drill1.0mm_Beaded
TP2, TP4, TP6, TP8, TP10, TP12: GND; TestPoint_Loop_D1.80mm_Drill1.0mm_Beaded
TP3: +12V_IN_B; TestPoint_Loop_D1.80mm_Drill1.0mm_Beaded
TP5: +12V_UNFS; TestPoint_Loop_D1.80mm_Drill1.0mm_Beaded
TP7: +12V; TestPoint_Loop_D1.80mm_Drill1.0mm_Beaded
TP9: OV_Z; TestPoint_Loop_D1.80mm_Drill1.0mm_Beaded
TP11: OV_TRIG; TestPoint_Loop_D1.80mm_Drill1.0mm_Beaded

Connections:
/+12V: C3.1, CN3.1, CN3.2, CN3.3, CN3.4, CN3.5, CN3.6, CN3.7, CN3.8, D7.2 (A), F1.1, Q1.2 (A), R4.1, TP7.1
GND: C1.2, C2.2, C3.2, C4.2, CN1.2, CN2.2, CN4.1, CN4.2, CN4.3, CN4.4, CN4.5, CN4.6, CN4.7, CN4.8, D1.2 (A), D2.2 (A), H1.1, H2.1, H3.1, H4.1, Q1.1 (K), R1.1, R2.1, R3.1, R5.2, TP2.1, TP4.1, TP6.1, TP8.1, TP10.1, TP12.1
unnamed: C1.1, CN1.1, D1.1 (K), D3.2 (A), D5.2 (A), TP1.1
unnamed: C2.1, CN2.1, D2.1 (K), D4.2 (A), D6.2 (A), TP3.1
unnamed: C4.1, D8.1 (K), R4.2, R5.1, TP9.1
unnamed: D3.1 (K), R1.2
unnamed: D4.1 (K), R2.2
unnamed: D5.1 (K), D6.1 (K), F1.2, TP5.1
unnamed: D7.1 (K), R3.2
unnamed: D8.2 (A), Q1.3 (G), TP11.1

Notes on the sheet:
Output assignments: 1: Daughterboard 2: Input 3: Stalk 1 (relay) 4: Stalk B (relay) 5: Stalk A (relay) 6: Stalk 2 (relay) 7-8: Spare

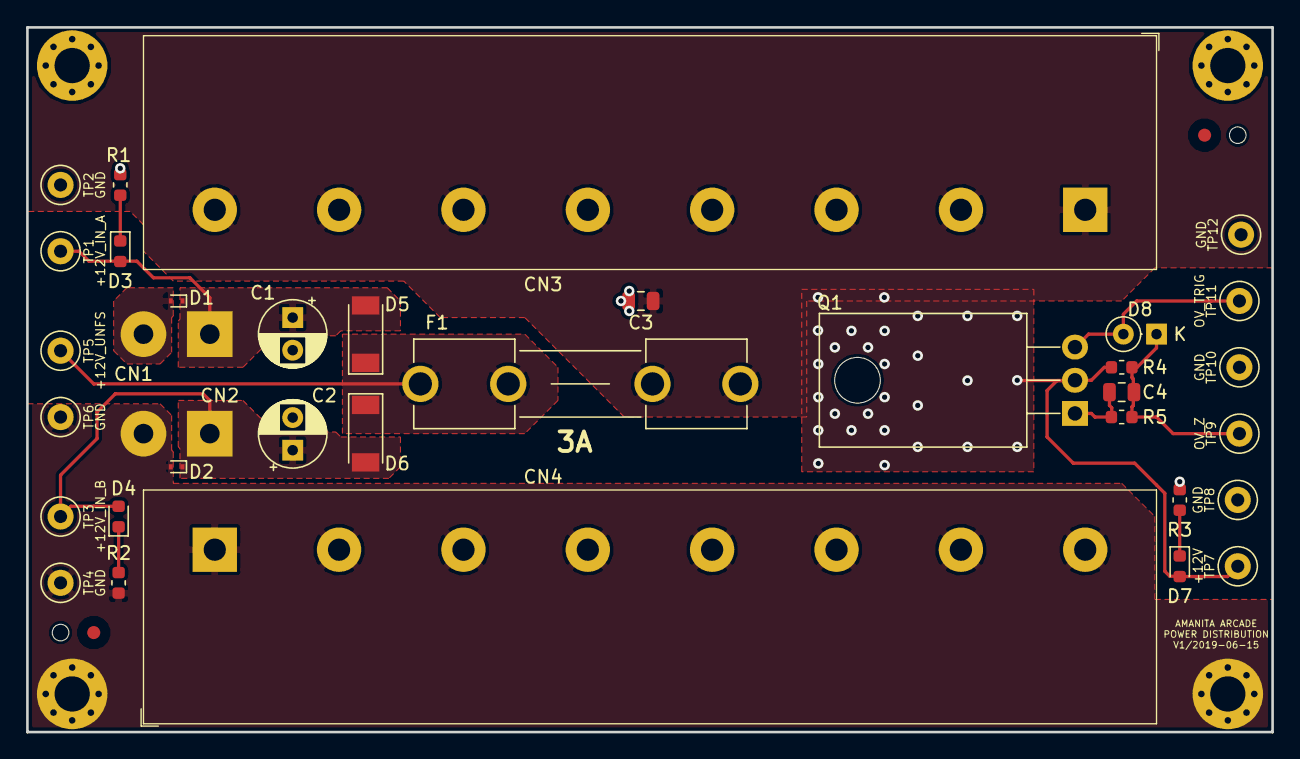
[picture p18: board aa-power.kicad_pcb from above]

Board: 2 copper layers, 95.4 x 54.0 mm, 43 parts (0 on the bottom side), 10 nets.
