jlunder/amanita-arcade/heart-control/src/heart_control.h

/*
 * heart_control.h
 *
 *  Created on: Oct 13, 2015
 *      Author: jlunder
 */

#ifndef HEART_CONTROL_H_
#define HEART_CONTROL_H_


#include <stdarg.h>
#include <stdbool.h>
#include <stdlib.h>
#include <stdint.h>
#include <stdio.h>
#include <string.h>

#include "cortexm/ExceptionHandlers.h"

#include "diag/Trace.h"

#include "stm32f4xx_hal.h"
#include "stm32f4xx_hal_gpio.h"
#include "stm32f4xx_hal_i2c.h"
#include "stm32f4xx_hal_i2s.h"
#include "stm32f4xx_hal_rcc.h"
#include "stm32f4xx_hal_spi.h"

#include "core_util.h"


#endif /* HEART_CONTROL_H_ */
