jlunder/amanita-arcade/(commit log)

2015-10-15 LED blinky test.
2015-10-17 Some kinda audio output when I don't use DMA?
2015-10-17 DMA circular buffer audio works! Yay
2016-06-02 Get touch working with MPR121 sensors
2016-06-04 Sketch out game logic, UART hardware implementation
2016-06-05 Add a couple high frequency timers.
2016-06-07 Add hardware support for WS2811 output via I2S -- fix problem with I2S clock generation (??? I think? How did this ever work with the CS43L22 though?)
    [amanita_arcade.h, peripherals.c]
2016-06-09 Fix color order in test pattern, bit order in output code
    [peripherals.c]
2016-07-01 Add timer support to HW lib, switch to bitbanged LED output.
2016-07-04 Fix cycle play bugs.
    [aa_lights.h, amanita_arcade.h]
2017-06-23 First pass input, much framework
2017-06-25 First pass of WS2812 output -- output works, seems stable over long(ish) cable runs.
2017-06-26 Beginning implementation of lights animation framework.
2017-06-27 First crack at new animation system
    [aa_color.cpp, aa_color.h, aa_game.cpp, aa_game.h, aa_lights.cpp, aa_lights.h, aa_texture_2d.cpp, aa_texture_2d.h]
2017-07-07 Fix pin assignment
2017-07-08 Much bugfixing, implement lights on button press
    [aa_color.cpp, aa_color.h, aa_game.cpp, aa_lights.cpp, aa_texture_2d.cpp]
2017-08-06 Initial values were causing the controller to think all buttons were held down constantly forever if PS2 controller not plugged in on boot.
2017-08-06 Fix rendering bugs, change gameplay to use the first button press as start of sequence
    [aa_color.h, aa_game.cpp, aa_game.h, amanita_arcade.h]
2018-07-02 Clean up some of the LED output code
2018-07-03 Add invert option to font rendering for the cursor
    [aa_game.cpp, aa_texture_2d.cpp, aa_texture_2d.h]
2018-07-03 Separate color reorder for panel and stalks... that was a confusing color problem
    [aa_color.h, aa_lights.cpp, aa_texture_2d.cpp, aa_texture_2d.h]
2018-07-29 Add VS Code .gitignore, make project work on latest Platform.IO (now it offers mbed upload for STM32F4Discovery which is not helpful)
2018-07-29 Fix broken uptime(), frame timing code
    [aa_game.cpp, amanita_arcade.cpp]
2018-07-29 Fix copy in comment
    [amanita_arcade.cpp]
2018-07-30 Implement watchdog timer!
2018-08-01 Fix timer bugs, add debug serial input simulation, reimplement game logic with a modular state machine, fix spurious assert in lights
    [aa_game.cpp, aa_game.h, aa_input.cpp, aa_input.h, aa_lights.cpp, aa_timer.cpp, aa_timer.h, amanita_arcade.cpp]
2018-08-06 Fix issues with transitions, make colors brace-initializable, rationalize draw function naming, improve logo texture, tweak viz
    [aa_color.cpp, aa_color.h, aa_game.cpp, aa_lights.cpp, aa_lights.h, aa_texture_2d.cpp, aa_texture_2d.h]
2018-08-07 Fix small bug with endgame handling
    [aa_game.cpp]
2018-08-27 Implement bitbang I2C for EEPROM
2019-04-19 Current LVDS/RS422 project -- pretty much ready for layout
    [aa-daughterboard-lvds.kicad_pcb, aa-daughterboard-lvds.sch]
2019-04-20 First run at aa-daughterboard (current loop version), plus WIP
    [_saved_aa-daughterboard-lvds.sch, aa-daughterboard-lvds.kicad_pcb, aa-daughterboard.kicad_pcb, aa-daughterboard.sch]
2019-04-22 Rough grouping of components done
    [_saved_aa-daughterboard-lvds.sch, aa-daughterboard-lvds.kicad_pcb, aa-daughterboard-lvds.sch]
2019-04-23 Add STM32 symbols... I don't think I have this right yet
    [_saved_aa-daughterboard-lvds.sch, aa-daughterboard-lvds.kicad_pcb, aa-daughterboard-lvds.sch]
2019-04-23 Name differential pairs, convert inconvenient 1x8 connectors to 2x4
    [aa-daughterboard-lvds.kicad_pcb, aa-daughterboard-lvds.sch]
2019-05-04 Routed, labeling done pending double check
    [aa-daughterboard-lvds.kicad_pcb, aa-daughterboard-lvds.sch]
2019-05-05 Tweaks and labeling changes
    [aa-daughterboard-lvds.kicad_pcb]
2019-05-18 Add new projects for remaining boards, remove cruft
    [aa-daughterboard-lvds-B.Cu.gbr, aa-daughterboard-lvds-B.Mask.gbr, aa-daughterboard-lvds-B.Paste.gbr, aa-daughterboard-lvds-B.SilkS.gbr, aa-daughterboard-lvds-Edge.Cuts.gbr, aa-daughterboard-lvds-F.Cu.gbr, aa-daughterboard-lvds-F.Mask.gbr, aa-daughterboard-lvds-F.Paste.gbr]
2019-05-18 Updates to schematic and layout -- remove test points, add jumpers, iterate layout
    [aa-stalk-receiver-lvds.kicad_pcb, aa-stalk-receiver-lvds.sch]
2019-05-22 Latest stalk receiver design -- many tweaks, layout V0 probably done
    [aa-stalk-receiver-lvds.kicad_pcb, aa-stalk-receiver-lvds.sch]
2019-05-22 Add BOM used for order, todos
    [bom-purchase-2019-05-20.ods]
2019-05-23 Updated notes
    [bom-purchase-2019-05-20.ods]
2019-05-24 Implement todos
    [aa-daughterboard-lvds.kicad_pcb, aa-daughterboard-lvds.sch]
2019-05-25 Finish implementing daughterboard todos, except BOM on silkscreen, update library tables.
    [aa-daughterboard-lvds.kicad_pcb]
2019-06-02 More updates to daughterboard, begin panel receiver layout
    [aa-daughterboard-lvds.kicad_pcb, aa-daughterboard-lvds.sch, aa-panel-receiver-lvds.kicad_pcb, aa-panel-receiver-lvds.sch]
2019-06-04 Add power distro board, resolve some todos, finish a coherent layout of the panel receiver
    [aa-panel-receiver-lvds.kicad_pcb, aa-panel-receiver-lvds.sch, aa-power.kicad_pcb, aa-power.sch, aa-stalk-receiver-lvds.kicad_pcb, aa-stalk-receiver-lvds.sch, bom-purchase-2019-05-20.ods]
2019-06-08 Update to use a shared schematic component/footprint library
    [aa-daughterboard-lvds.kicad_pcb, aa-daughterboard-lvds.sch, aa-input-controller.sch, aa-panel-receiver-lvds.kicad_pcb, aa-panel-receiver-lvds.sch, aa-stalk-receiver-lvds.kicad_pcb, aa-stalk-receiver-lvds.sch]
2019-06-09 Design, lay out power protection/distribution board
    [aa-power.kicad_pcb, aa-power.sch]
2019-06-10 Fix bad test point label
    [aa-daughterboard-lvds.kicad_pcb]
2019-06-10 Fix spurious assert fail, tidy
    [aa_timer.cpp, amanita_arcade.cpp]
2019-06-10 WIP work on I2C
2019-06-16 Substantial rework of system, new layouts done for daughterboard, power, stalk receiver
    [aa-daughterboard-lvds.kicad_pcb, aa-daughterboard-lvds.sch, aa-panel-receiver-lvds.kicad_pcb, aa-panel-receiver-lvds.sch, aa-power.kicad_pcb, aa-power.sch, aa-stalk-receiver-lvds.kicad_pcb, aa-stalk-receiver-lvds.sch]
2019-06-16 Renumber and duplicate layout for panel receiver -- layout not complete
    [aa-panel-receiver-lvds.kicad_pcb, aa-panel-receiver-lvds.sch]
2019-06-17 Placement of components on panel receiver board, routing TBD
    [aa-panel-receiver-lvds.kicad_pcb, aa-panel-receiver-lvds.sch]
2019-06-20 Second rount almost ready, less fiducials
    [aa-daughterboard-lvds-B.Cu.gbr, aa-daughterboard-lvds-B.Mask.gbr, aa-daughterboard-lvds-B.Paste.gbr, aa-daughterboard-lvds-B.SilkS.gbr, aa-daughterboard-lvds-Edge.Cuts.gbr, aa-daughterboard-lvds-F.Cu.gbr, aa-daughterboard-lvds-F.Mask.gbr, aa-daughterboard-lvds-F.Paste.gbr]
2019-06-22 Final designs and actual sent gerbers for first for-real run
    [aa-daughterboard-lvds-B.Cu.gbr, aa-daughterboard-lvds-B.Mask.gbr, aa-daughterboard-lvds-B.Paste.gbr, aa-daughterboard-lvds-B.SilkS.gbr, aa-daughterboard-lvds-Edge.Cuts.gbr, aa-daughterboard-lvds-F.Cu.gbr, aa-daughterboard-lvds-F.Mask.gbr, aa-daughterboard-lvds-F.Paste.gbr]
2019-06-24 Second run of PCBs for Amanita Arcade
    [aa-input-controller-B.Cu.gbr, aa-input-controller-B.Mask.gbr, aa-input-controller-B.Paste.gbr, aa-input-controller-B.SilkS.gbr, aa-input-controller-Edge.Cuts.gbr, aa-input-controller-F.Cu.gbr, aa-input-controller-F.Mask.gbr, aa-input-controller-F.Paste.gbr]
2019-07-01 Sent to manufacturing
    [aa-bom-v1.ods]
2019-08-07 Minor board updates to fix issues discovered during build
    [aa-input-controller.kicad_pcb, aa-input-controller.sch, aa-panel-receiver-lvds.kicad_pcb, aa-panel-receiver-lvds.sch, aa-stalk-receiver-lvds.kicad_pcb, aa-stalk-receiver-lvds.sch]
2019-08-07 Add STM32 port of input controller
2019-08-07 Remove old Arduino code for input controller
2019-08-08 Fix button order
2019-08-08 Fix silkscreen for stalk connectors
    [aa-daughterboard-lvds.kicad_pcb, aa-stalk-receiver-lvds.kicad_pcb]
2019-08-19 Fix label ordering to match board
    [aa-input-controller.sch]
2019-08-19 Reorganize code, fix bugs -- input board recovers properly now
    [PSGamepad.cpp, aa_color.h, aa_game.cpp, aa_input.cpp, aa_lights.cpp, aa_lights.h, aa_timer.cpp, amanita_arcade.cpp]
2019-08-19 Add watchdog timer to input board
2019-09-05 Add initial hi score implementation, add debug interface, move game vis and hi score stuff to their own files, switch to C++17
2019-09-10 Switch color to 8:8:8:8 fixed point, add render debug, fix stuck transition times
    [aa_color.cpp, aa_color.h, aa_game_vis.cpp, aa_lights.cpp, aa_texture_2d.cpp, aa_texture_2d.h]
2019-09-23 Rework lights output to use DMA -- hopefully this won't be so finicky
    [aa_lights.cpp, amanita_arcade.cpp]
2022-07-01 Fix DMA output to be more reliable (no sparklies!)
    [aa_lights.cpp, aa_lights.h]
2022-07-01 Return to old pins, USART3 and I2C3 don't conflict
2022-07-03 Switch to RTOS build of mbed for aa-main
2022-07-03 Streamline input firmware, fix reset issue
    [PSGamepad.cpp, PSGamepad.h, aa_input.h, main.cpp]
2022-07-06 Improve RNG, fix input thread, double-buffer lights
    [aa_game.cpp, aa_game_vis.cpp, aa_input.cpp, aa_lights.cpp, aa_lights.h, amanita_arcade.cpp, amanita_arcade.h]
